findasifrahman/zynq_soc_board_v1/zynq_soc_board_v1.kicad_pcb

## KiCad design zynq_soc_board_v1.kicad_pcb (2024-12-31)

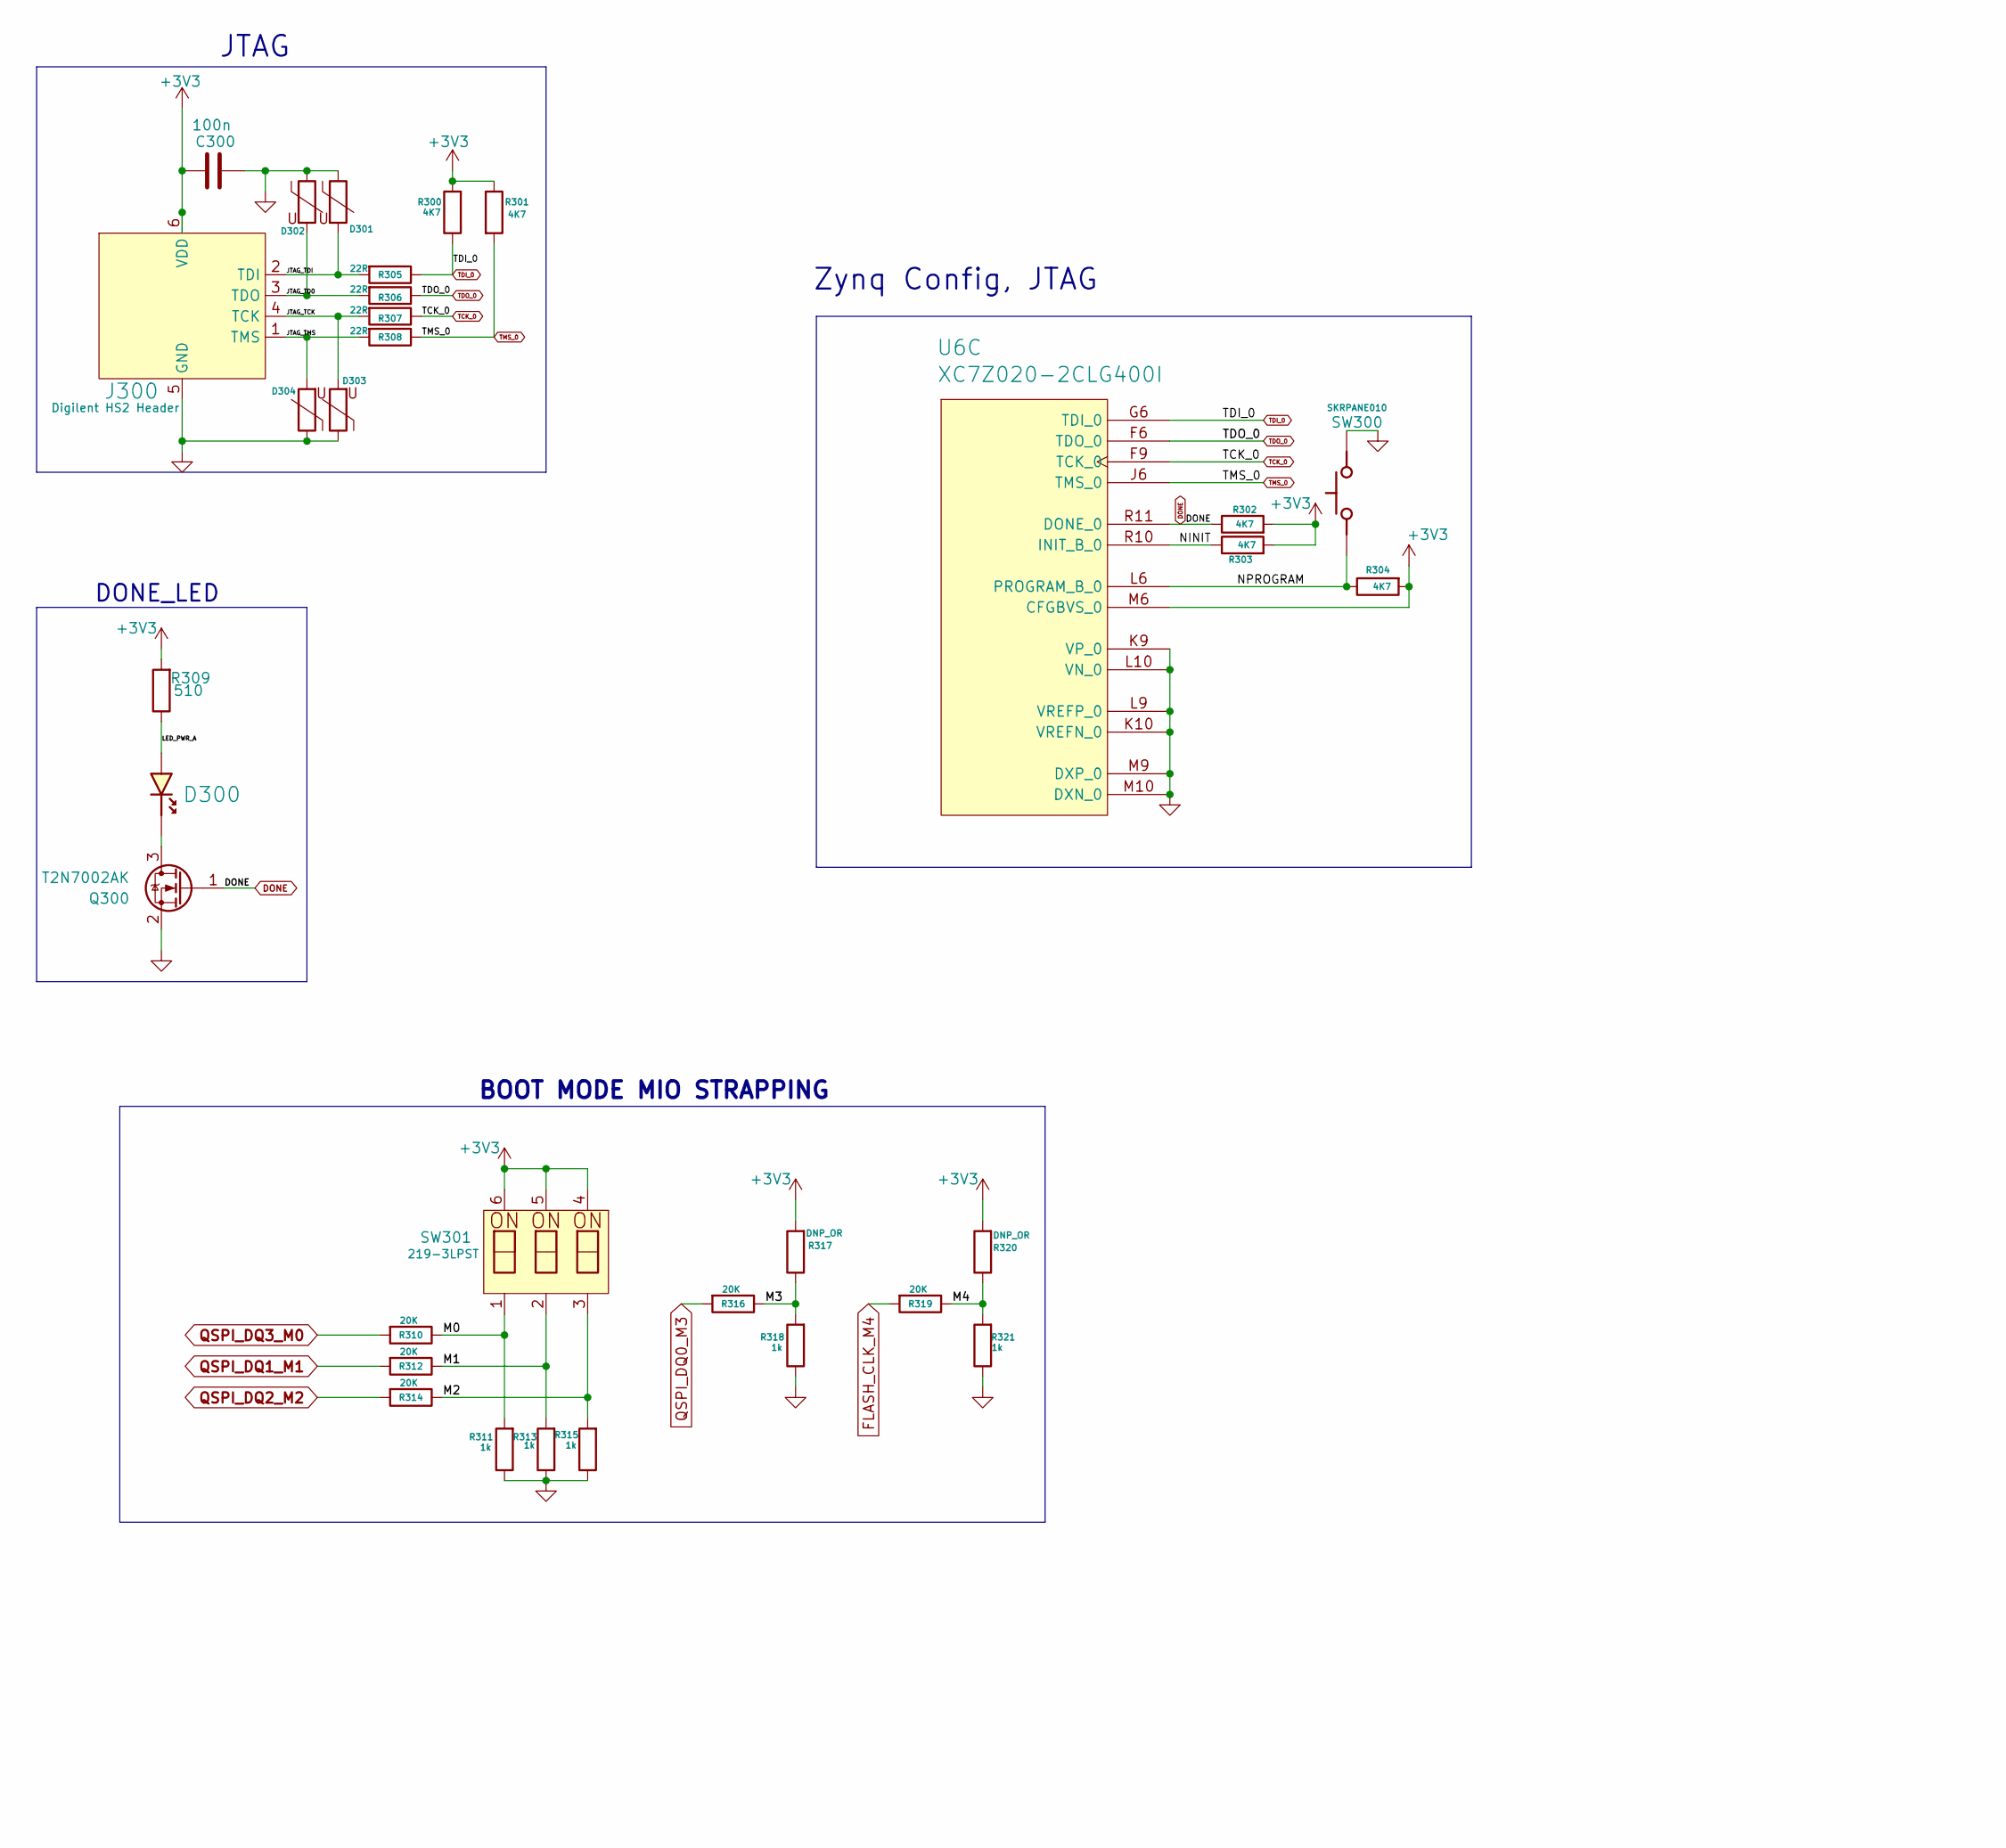
[picture p1: schematic zynq_jtag.kicad_sch, Zynq Config, JTAG, Debug, part in row 1, column 1]

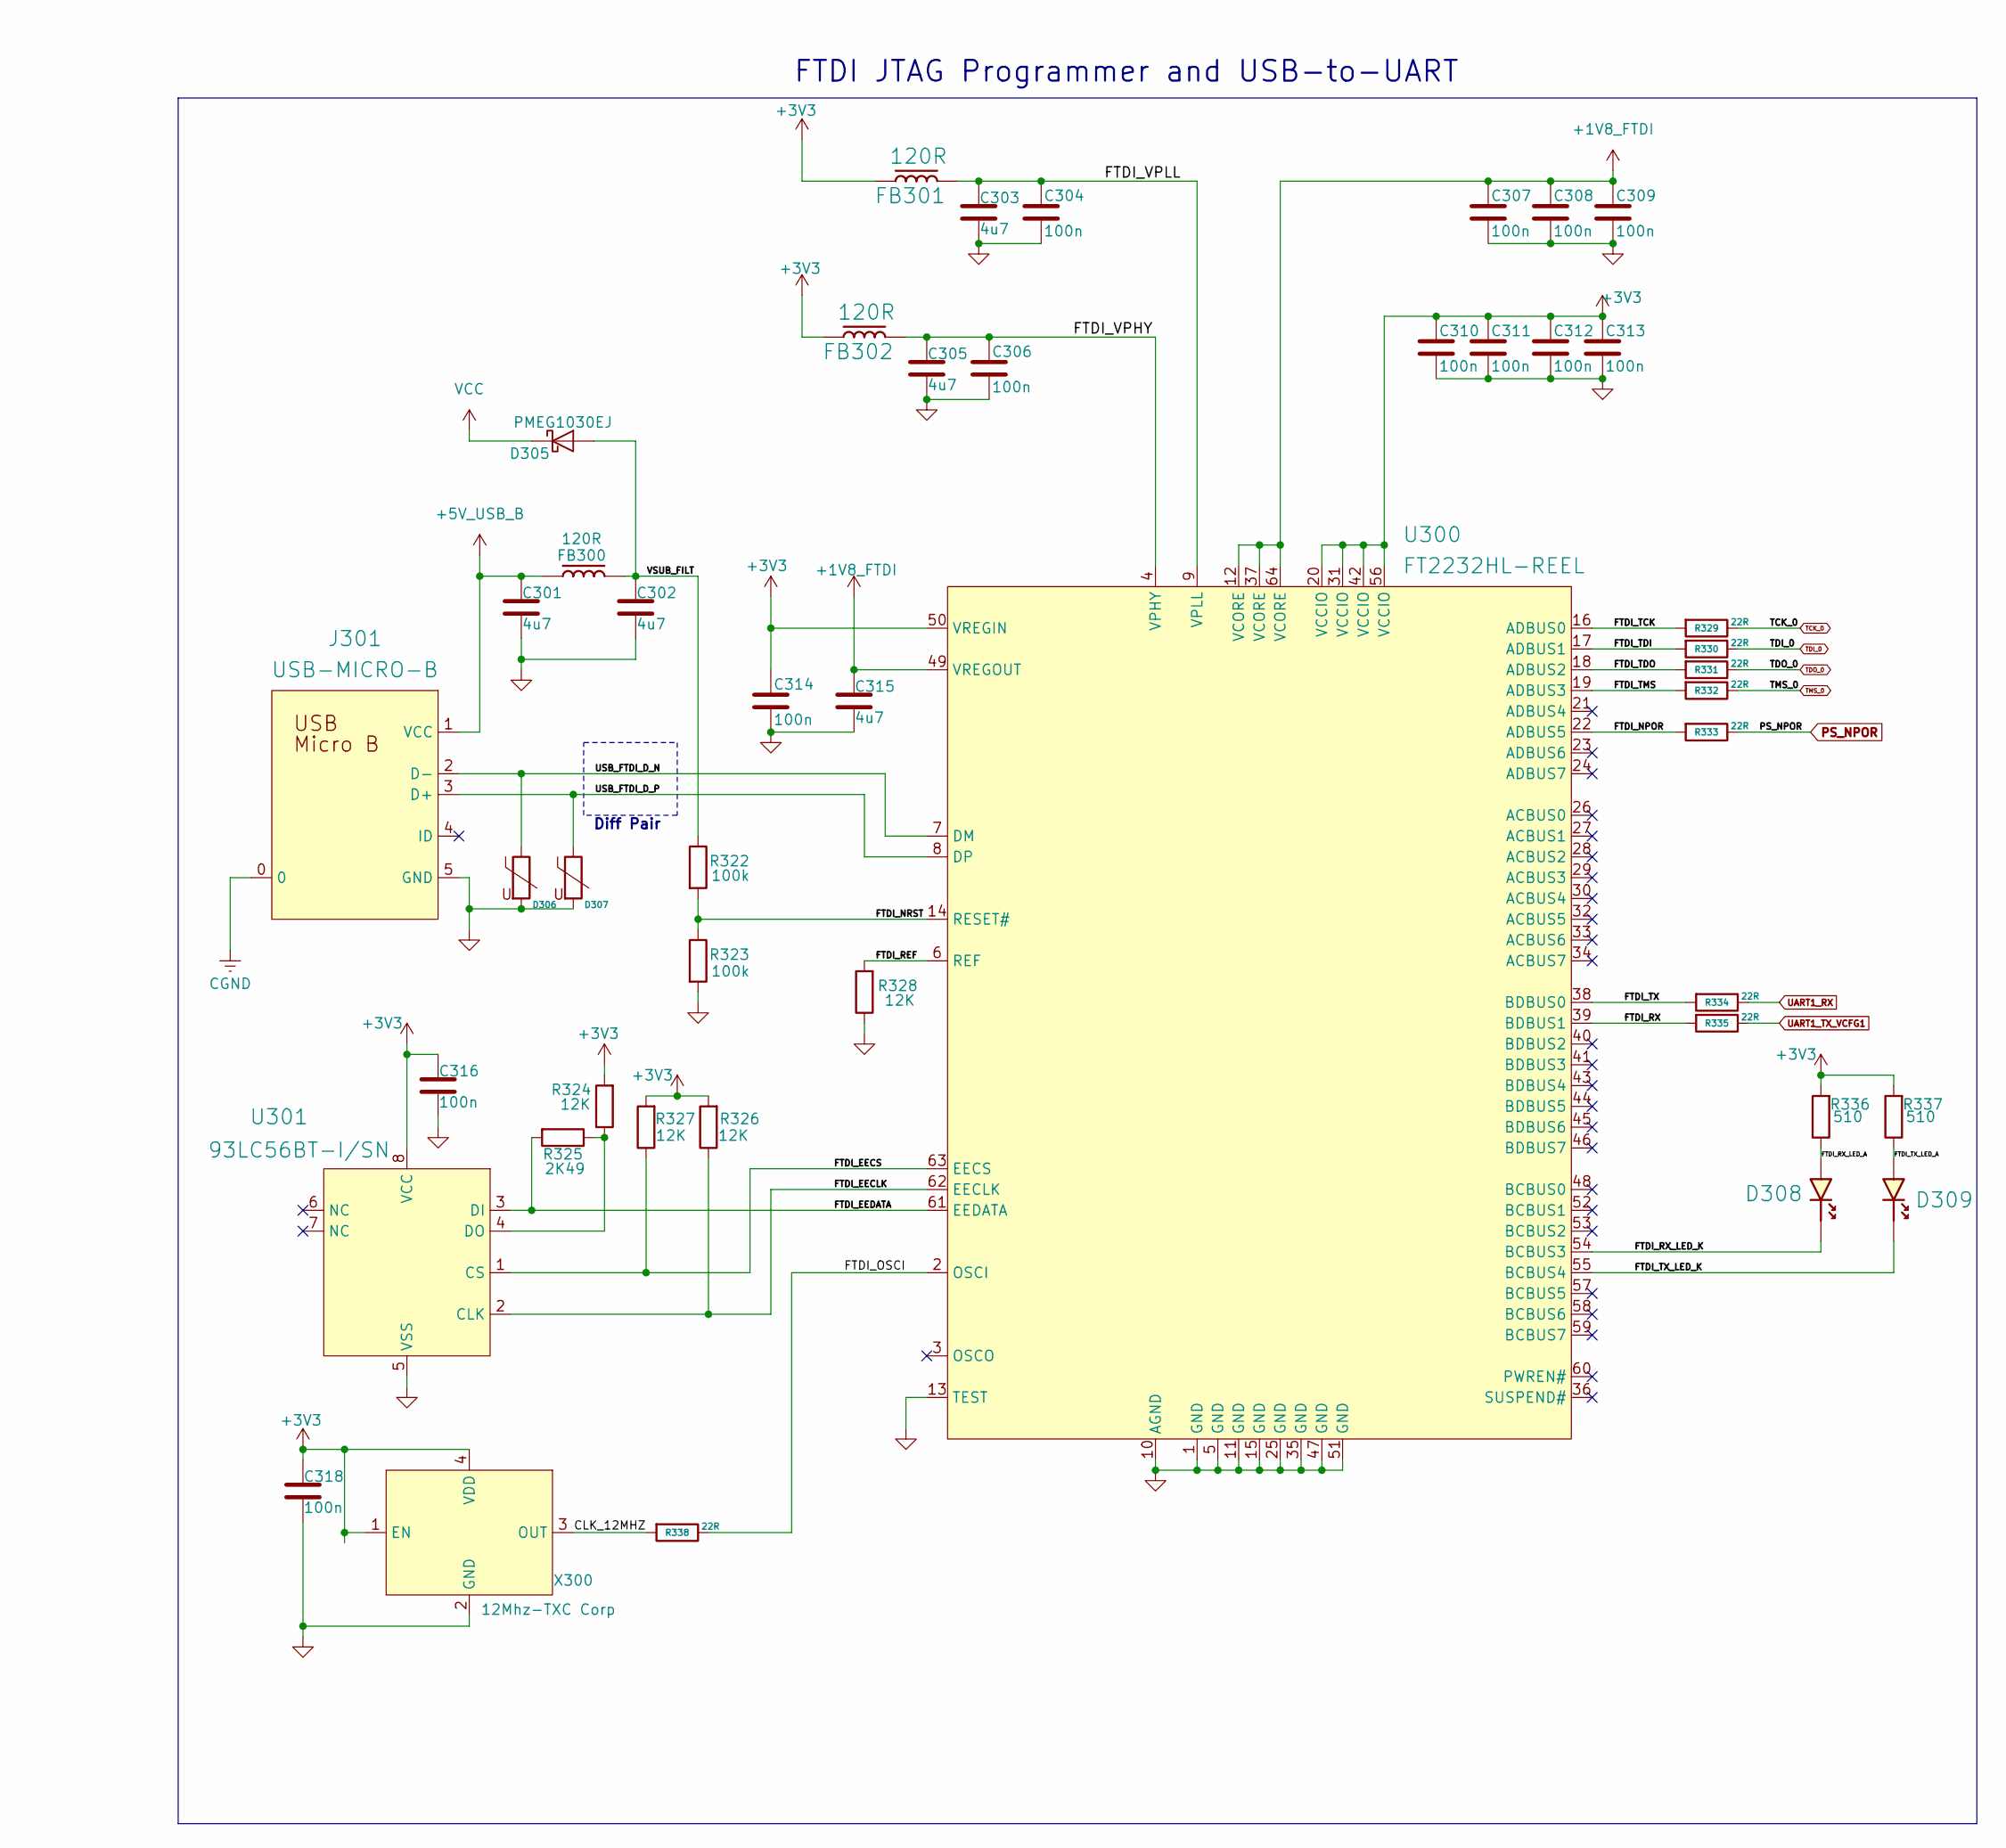
[picture p2: schematic zynq_jtag.kicad_sch, Zynq Config, JTAG, Debug, part in row 1, column 2]

Parts:
C300, C304, C306, C307, C308, C309, C310, C311, C312, C313, C314, C316, C318: 100n; C_0402_1005Metric; Manufacturer Part Number CL05B104KO5NNNC; LCSC C1525
C301, C302, C303, C305, C315: 4u7; C_0402_1005Metric; Manufacturer Part Number CL05A475MP5NRNC; LCSC C23733
D300, D308, D309: RED; LED_0402_RED; Manufacturer Part Number NCD0402R1; LCSC C130719
D301, D302: Varistor; C0402; Manufacturer Part Number CG0402MLU-3.3G; LCSC C2655393
D303, D304, D306, D307: Varistor; D_0402_1005Metric; Manufacturer Part Number CG0402MLU-3.3G; LCSC C2655393
D305: PMEG1030EJ; SOD-323_L1.8-W1.3-LS2.5-RD; LCSC C133633
FB300, FB301, FB302: 120R; FB_0402; Manufacturer Part Number GZ1005D121TF; LCSC C38480
J300: Digilent HS2 Header; DIGILENT_HS2; Manufacturer Part Number 68000-406HLF; LCSC C178289
J301: USB-MICRO-B; MICRO-USB-SMD_5P-P0.65-H-M_MICRO-USB-5P; Manufacturer Part Number 920-D62A2021S10100; LCSC C40942
Q300: T2N7002AK; SOT-23; Manufacturer Part Number T2N7002AK,LM; LCSC C516175
R300, R301, R302, R303, R304: 4K7; R_0402_1005Metric; Manufacturer Part Number 0402WGF4701TCE; LCSC C25900
R305, R306, R307, R308, R329, R330, R331, R332, R333, R334, R335, R338: 22R; R_0402_1005Metric; Manufacturer Part Number 0402WGF220JTCE; LCSC C25092
R309, R336, R337: 510; R_0402_1005Metric; Manufacturer Part Number RC-02W511JT; LCSC C1119
R310, R312, R314, R316, R319: 20K; R0201; Manufacturer Part Number RC0201FR-0720KL; LCSC C295787
R311, R313, R315, R318, R321: 1k; R_0402_1005Metric; Manufacturer Part Number 0402WGF1001TCE; LCSC C11702
R317, R320: DNP_OR; R_0402_1005Metric
R322, R323: 100k; R_0402_1005Metric; Manufacturer Part Number 0402WGF1003TCE; LCSC C25741
R324, R326, R327, R328: 12K; R_0402_1005Metric; Manufacturer Part Number 0402WGF1202TCE; LCSC C25752
R325: 2K49; R_0402_1005Metric; Manufacturer Part Number 0402WGF2491TCE; LCSC C25884
SW300: SKRPANE010; Manufacturer Part Number SKRPANE010; LCSC C470426
SW301: 219-3LPST; Manufacturer Part Number 219-3LPSTR; LCSC C2961925
U6: XC7Z020-2CLG400I; Xilinx_CLG400; PartNumber XC7Z010-1CLG400C; LCSC C569043
U300: FT2232HL-REEL; LQFP-64-0.5mm; Manufacturer Part Number FT2232HL-REEL; LCSC C27882
U301: 93LC56BT-I/SN; SOIC-8; Manufacturer Part Number 93LC56B-I/SN; LCSC C183620
X300: 12Mhz-TXC Corp; XTAL_2520; Manufacturer Part Number 8W12000010; LCSC C409301

Connections:
+1V8_FTDI: C307.1, C308.1, C309.1, C315.1, U300.12 (VCORE), U300.37 (VCORE), U300.49 (VREGOUT), U300.64 (VCORE)
+3V3: C300.1, C310.1, C311.1, C312.1, C313.1, C314.1, C316.1, C318.1, FB301.1, FB302.1, J300.6 (VDD), R300.2, R301.1, R302.2, R303.2, R304.2, R309.2, R317.2, R320.2, R324.2, R326.2, R327.2, R336.2, R337.2, SW301.4, SW301.5, SW301.6, U6.M6 (CFGBVS_0), U300.20 (VCCIO), U300.31 (VCCIO), U300.42 (VCCIO), U300.50 (VREGIN), U300.56 (VCCIO), U301.8 (VCC), X300.1 (EN), X300.4 (VDD); also elsewhere on the board
+5V_USB_B: C301.1, FB300.1, J301.1 (VCC)
/zynq_jtag/CLK_12MHZ: R338.2, X300.3 (OUT)
/zynq_jtag/FTDI_EECLK: R326.1, U300.62 (EECLK), U301.2 (CLK)
/zynq_jtag/FTDI_EECS: R327.1, U300.63 (EECS), U301.1 (CS)
/zynq_jtag/FTDI_EEDATA: R325.2, U300.61 (EEDATA), U301.3 (DI)
/zynq_jtag/FTDI_NPOR: R333.2, U300.22 (ADBUS5)
/zynq_jtag/FTDI_NRST: R322.2, R323.1, U300.14 (RESET#)
/zynq_jtag/FTDI_OSCI: R338.1, U300.2 (OSCI)
/zynq_jtag/FTDI_REF: R328.2, U300.6 (REF)
/zynq_jtag/FTDI_RX: R335.2, U300.39 (BDBUS1)
/zynq_jtag/FTDI_RX_LED_A: D308.A, R336.1
/zynq_jtag/FTDI_RX_LED_K: D308.K, U300.54 (BCBUS3)
/zynq_jtag/FTDI_TCK: R329.2, U300.16 (ADBUS0)
/zynq_jtag/FTDI_TDI: R330.2, U300.17 (ADBUS1)
/zynq_jtag/FTDI_TDO: R331.2, U300.18 (ADBUS2)
/zynq_jtag/FTDI_TMS: R332.2, U300.19 (ADBUS3)
/zynq_jtag/FTDI_TX: R334.2, U300.38 (BDBUS0)
/zynq_jtag/FTDI_TX_LED_A: D309.A, R337.1
/zynq_jtag/FTDI_TX_LED_K: D309.K, U300.55 (BCBUS4)
/zynq_jtag/FTDI_VPHY: C305.1, C306.1, FB302.2, U300.4 (VPHY)
/zynq_jtag/FTDI_VPLL: C303.1, C304.1, FB301.2, U300.9 (VPLL)
/zynq_jtag/JTAG_TCK: D303.2, J300.4 (TCK), R307.2
/zynq_jtag/JTAG_TD0: D302.2, J300.3 (TDO), R306.2
/zynq_jtag/JTAG_TDI: D301.2, J300.2 (TDI), R305.2
/zynq_jtag/JTAG_TMS: D304.2, J300.1 (TMS), R308.2
/zynq_jtag/LED_PWR_A: D300.A, R309.1
/zynq_jtag/M0: R310.1, R311.2, SW301.1
/zynq_jtag/M1: R312.1, R313.2, SW301.2
/zynq_jtag/M2: R314.1, R315.2, SW301.3
/zynq_jtag/M3: R316.1, R317.1, R318.2
/zynq_jtag/M4: R319.1, R320.1, R321.2
/zynq_jtag/NINIT: R303.1, U6.R10 (INIT_B_0)
/zynq_jtag/NPROGRAM: R304.1, SW300.34, U6.L6 (PROGRAM_B_0)
/zynq_jtag/USB_FTDI_D_N: D306.1, J301.2 (D-), U300.7 (DM)
/zynq_jtag/USB_FTDI_D_P: D307.1, J301.3 (D+), U300.8 (DP)
/zynq_jtag/VSUB_FILT: C302.1, D305.2 (A), FB300.2, R322.1
CGND: J301.0; also elsewhere on the board
DONE: Q300.1 (G), R302.1, U6.R11 (DONE_0); also elsewhere on the board
FLASH_CLK_M4: R319.2
GND: C300.2, C301.2, C302.2, C303.2, C304.2, C305.2, C306.2, C307.2, C308.2, C309.2, C310.2, C311.2, C312.2, C313.2, C314.2, C315.2, C316.2, C318.2, D301.1, D302.1, D303.1, D304.1, D306.2, D307.2, J300.5 (GND), J301.5 (GND), Q300.2 (S), R311.1, R313.1, R315.1, R318.1, R321.1, R323.2, R328.1, SW300.12, U6.K9 (VP_0), U6.K10 (VREFN_0), U6.L9 (VREFP_0), U6.L10 (VN_0), U6.M9 (DXP_0), U6.M10 (DXN_0), U300.1 (GND), U300.5 (GND), U300.10 (AGND), U300.11 (GND), U300.13 (TEST), U300.15 (GND), U300.25 (GND), U300.35 (GND), U300.47 (GND), U300.51 (GND), U301.5 (VSS), X300.2 (GND); also elsewhere on the board
unnamed: D300.K, Q300.3 (D)
unnamed: R324.1, R325.1, U301.4 (DO)
PS_NPOR: R333.1; also elsewhere on the board
QSPI_DQ0_M3: R316.2; also elsewhere on the board
QSPI_DQ1_M1: R312.2; also elsewhere on the board
QSPI_DQ2_M2: R314.2; also elsewhere on the board
QSPI_DQ3_M0: R310.2; also elsewhere on the board
TCK_0: R307.1, R329.1, U6.F9 (TCK_0)
TDI_0: R300.1, R305.1, R330.1, U6.G6 (TDI_0)
TDO_0: R306.1, R331.1, U6.F6 (TDO_0)
TMS_0: R301.2, R308.1, R332.1, U6.J6 (TMS_0)
UART1_RX: R334.1; also elsewhere on the board
UART1_TX_VCFG1: R335.1; also elsewhere on the board
VCC: D305.1 (K); also elsewhere on the board

Notes on the sheet:
Diff Pair
JTAG
Zynq Config, JTAG
BOOT MODE MIO STRAPPING
FTDI JTAG Programmer and USB-to-UART
DONE_LED
