findasifrahman/zynq_soc_board_v1/zynq_soc_board_v1.kicad_pcb

## KiCad design zynq_soc_board_v1.kicad_pcb (continued)

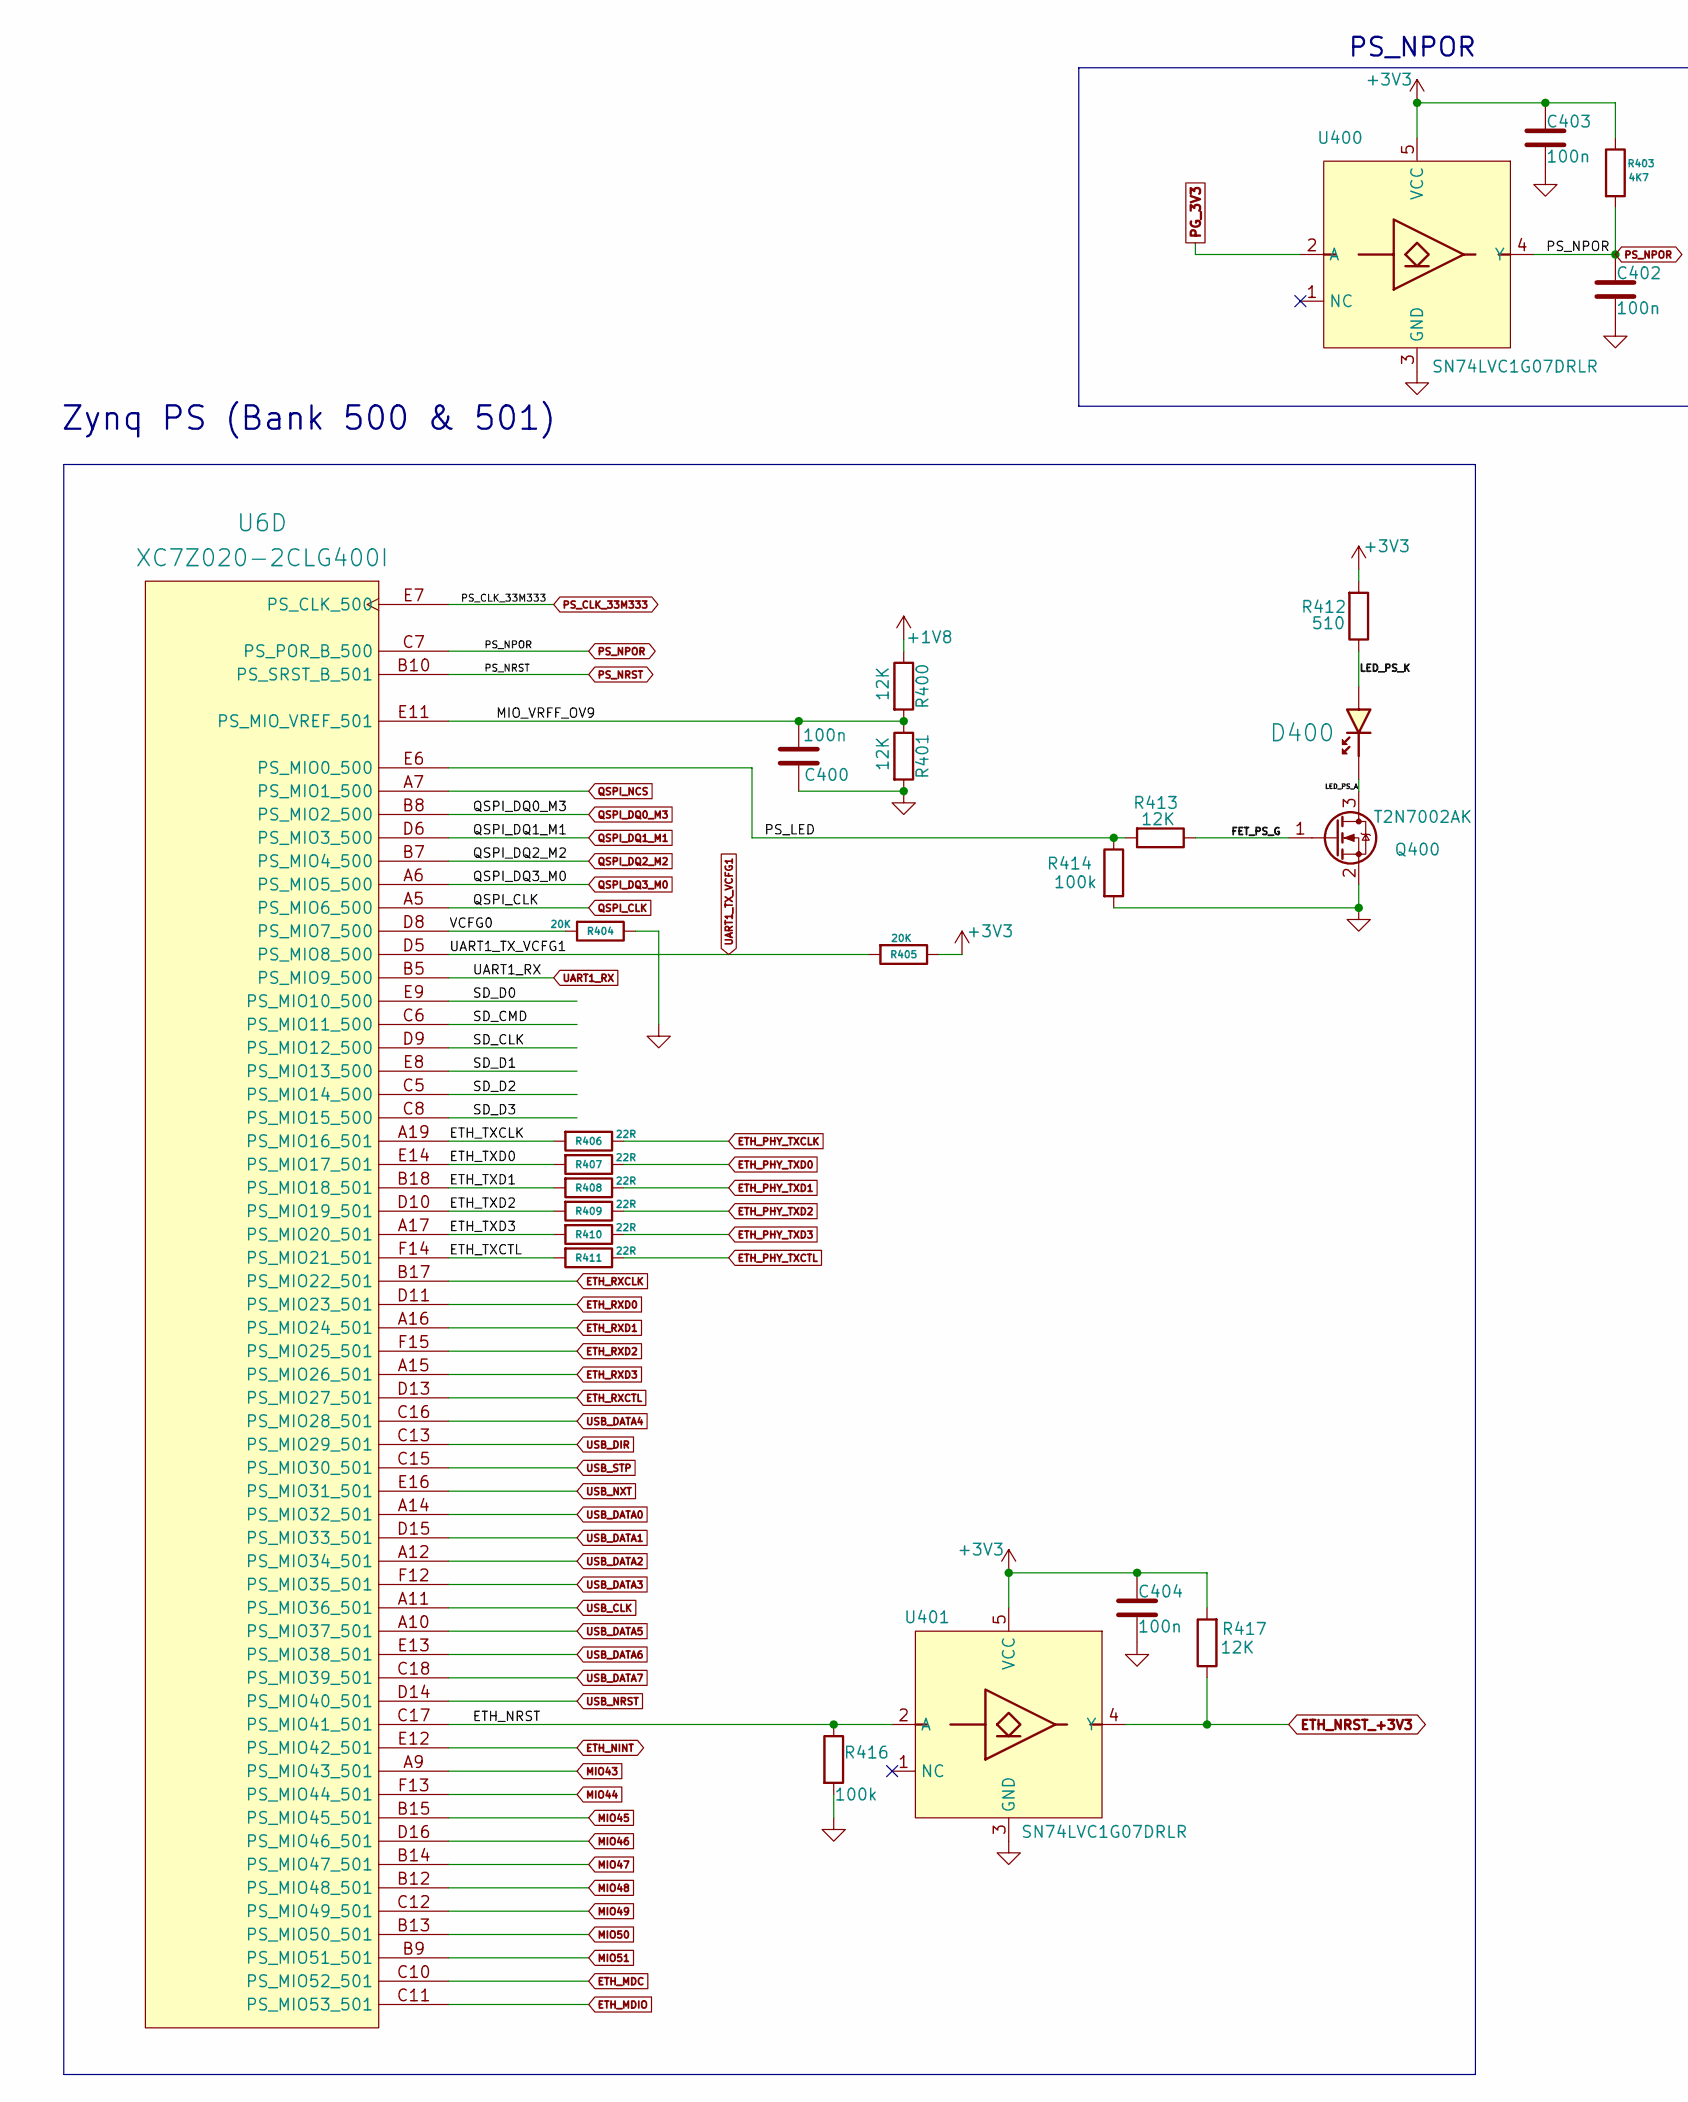
[picture p3: schematic zynq_processing_system_ps.kicad_sch, part in row 1, column 1]

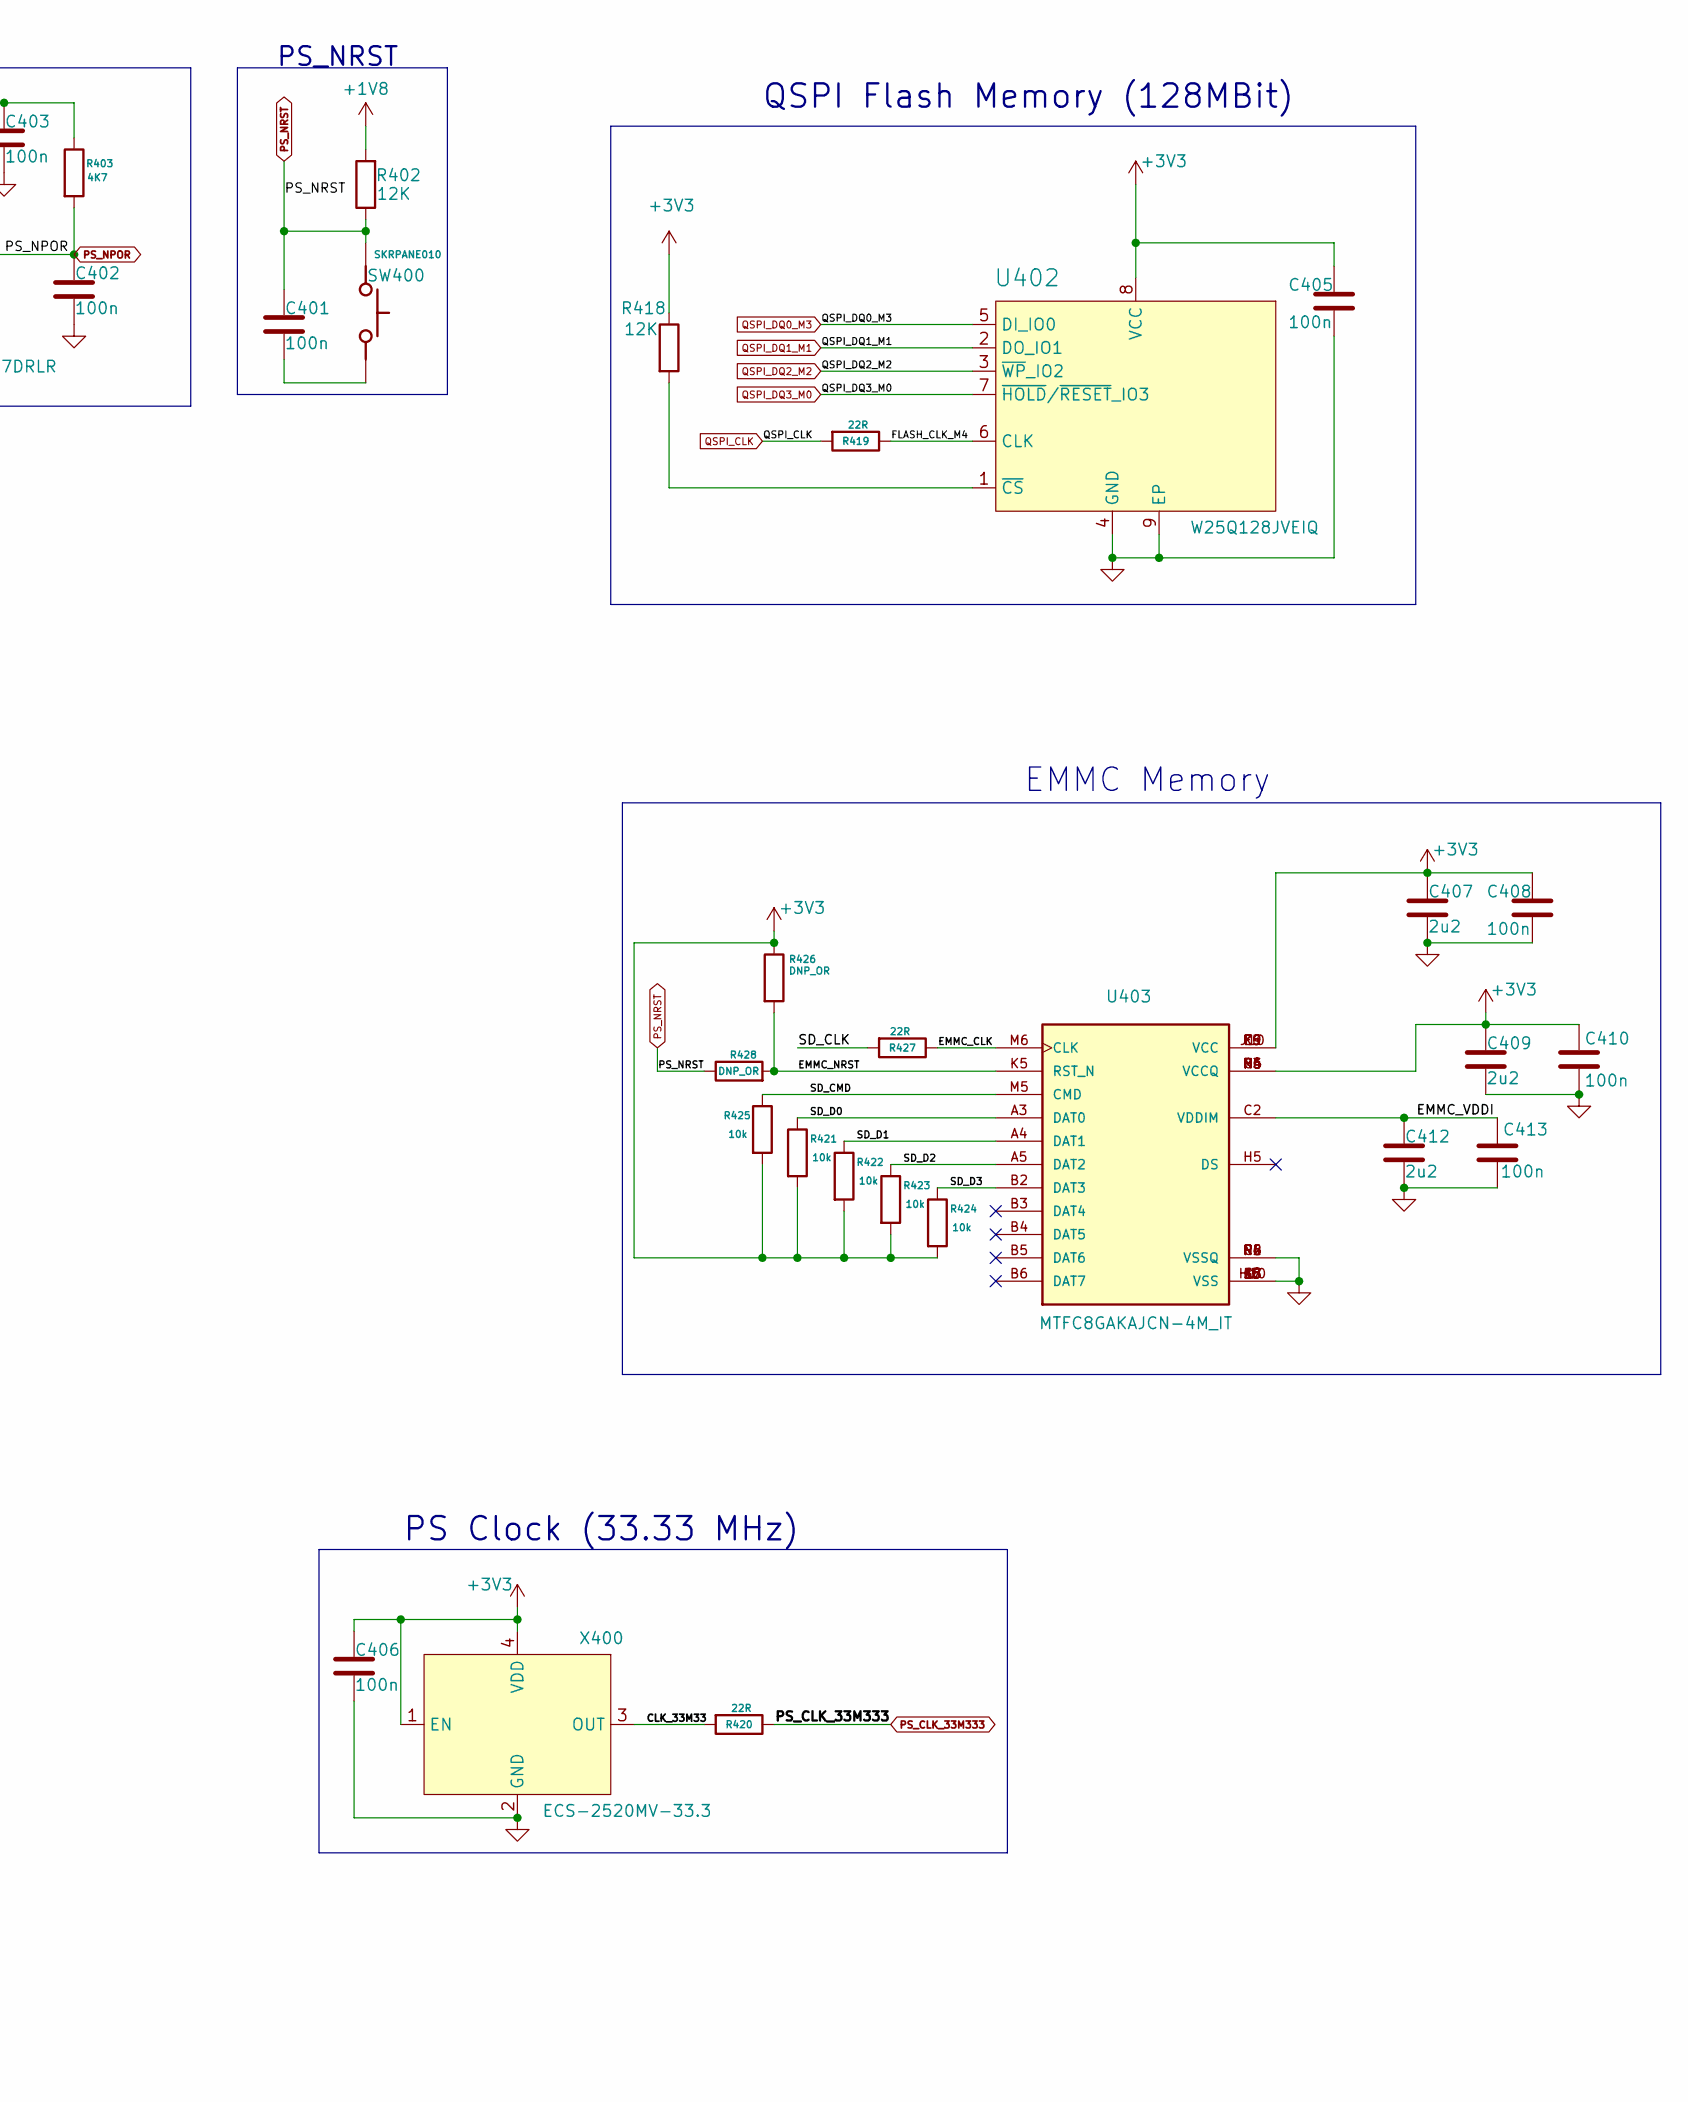
[picture p4: schematic zynq_processing_system_ps.kicad_sch, part in row 1, column 2]

Parts:
C400, C401, C402, C403, C404, C405, C406, C408, C410, C413: 100n; C_0402_1005Metric; Manufacturer Part Number CL05B104KO5NNNC; LCSC C1525
C407, C409, C412: 2u2; C_0402_1005Metric; Manufacturer Part Number CL05A225MQ5NSNC; LCSC C12530
D400: RED; LED_0402_RED; Manufacturer Part Number NCD0402R1; LCSC C130719
Q400: T2N7002AK; SOT-23; Manufacturer Part Number T2N7002AK,LM; LCSC C516175
R400, R401, R402, R413, R417, R418: 12K; R_0402_1005Metric; Manufacturer Part Number 0402WGF1202TCE; LCSC C25752
R403: 4K7; R_0402_1005Metric; Manufacturer Part Number 0402WGF4701TCE; LCSC C25900
R404, R405: 20K; R0201; Manufacturer Part Number RC0201FR-0720KL; LCSC C295787
R406, R407, R408, R409, R410, R411, R419, R420, R427: 22R; R_0402_1005Metric; Manufacturer Part Number 0402WGF220JTCE; LCSC C25092
R412: 510; R_0402_1005Metric; Manufacturer Part Number RC-02W511JT; LCSC C1119
R414, R416: 100k; R_0402_1005Metric; Manufacturer Part Number 0402WGF1003TCE; LCSC C25741
R421, R422, R423, R424, R425: 10k; R_0402_1005Metric; Manufacturer Part Number 0402WGF1002TCE; LCSC C25744
R426, R428: DNP_OR; R_0402_1005Metric
SW400: SKRPANE010; Manufacturer Part Number SKRPANE010; LCSC C470426
U6: XC7Z020-2CLG400I; Xilinx_CLG400; PartNumber XC7Z010-1CLG400C; LCSC C569043
U400, U401: SN74LVC1G07DRLR; SOT-5; Manufacturer Part Number SN74LVC1G07DRLR; LCSC C183013
U402: W25Q128JVEIQ; WSON-8-8X6; Manufacturer Part Number W25Q128JVEIQ; LCSC C401662
U403: MTFC8GAKAJCN-4M_IT; FBGA-153_L13.0-W11.5-P0.50_KLMAG1JETD-B041; LCSC C395384
X400: ECS-2520MV-33.3; XTAL_2520; Manufacturer Part Number ECS-2520MV-333.3-BN-TR; LCSC C405468

Connections:
+1V8: R400.1, R402.2; also elsewhere on the board
+3V3: C403.1, C404.1, C405.1, C406.1, C407.1, C408.1, C409.1, C410.1, R403.1, R405.1, R412.2, R417.2, R418.1, R421.2, R422.2, R423.2, R424.2, R425.2, R426.1, U400.5 (VCC), U401.5 (VCC), U402.8 (VCC), U403.C6 (VCCQ), U403.E6 (VCC), U403.F5 (VCC), U403.J10 (VCC), U403.K9 (VCC), U403.M4 (VCCQ), U403.N4 (VCCQ), U403.P3 (VCCQ), U403.P5 (VCCQ), X400.1 (EN), X400.4 (VDD); also elsewhere on the board
/zynq_processing_system_ps/CLK_33M33: R420.2, X400.3 (OUT)
/zynq_processing_system_ps/EMMC_CLK: R427.1, U403.M6 (CLK)
/zynq_processing_system_ps/EMMC_NRST: R426.2, R428.2, U403.K5 (RST_N)
/zynq_processing_system_ps/EMMC_VDDI: C412.1, C413.1, U403.C2 (VDDIM)
/zynq_processing_system_ps/ETH_NRST: R416.1, U6.C17 (PS_MIO41_501), U401.2 (A)
/zynq_processing_system_ps/ETH_TXCLK: R406.2, U6.A19 (PS_MIO16_501)
/zynq_processing_system_ps/ETH_TXCTL: R411.2, U6.F14 (PS_MIO21_501)
/zynq_processing_system_ps/ETH_TXD0: R407.2, U6.E14 (PS_MIO17_501)
/zynq_processing_system_ps/ETH_TXD1: R408.2, U6.B18 (PS_MIO18_501)
/zynq_processing_system_ps/ETH_TXD2: R409.2, U6.D10 (PS_MIO19_501)
/zynq_processing_system_ps/ETH_TXD3: R410.2, U6.A17 (PS_MIO20_501)
/zynq_processing_system_ps/FET_PS_G: Q400.1 (G), R413.1
/zynq_processing_system_ps/FLASH_CLK_M4: R419.1, U402.6 (CLK)
/zynq_processing_system_ps/LED_PS_A: D400.K, Q400.3 (D)
/zynq_processing_system_ps/LED_PS_K: D400.A, R412.1
/zynq_processing_system_ps/MIO_VRFF_OV9: C400.2, R400.2, R401.1, U6.E11 (PS_MIO_VREF_501)
/zynq_processing_system_ps/PS_LED: R413.2, R414.1, U6.E6 (PS_MIO0_500)
/zynq_processing_system_ps/SD_CLK: R427.2, U6.D9 (PS_MIO12_500)
/zynq_processing_system_ps/SD_CMD: R425.1, U6.C6 (PS_MIO11_500), U403.M5 (CMD)
/zynq_processing_system_ps/SD_D0: R421.1, U6.E9 (PS_MIO10_500), U403.A3 (DAT0)
/zynq_processing_system_ps/SD_D1: R422.1, U6.E8 (PS_MIO13_500), U403.A4 (DAT1)
/zynq_processing_system_ps/SD_D2: R423.1, U6.C5 (PS_MIO14_500), U403.A5 (DAT2)
/zynq_processing_system_ps/SD_D3: R424.1, U6.C8 (PS_MIO15_500), U403.B2 (DAT3)
/zynq_processing_system_ps/VCFG0: R404.2, U6.D8 (PS_MIO7_500)
ETH_MDC: U6.C10 (PS_MIO52_501); also elsewhere on the board
ETH_MDIO: U6.C11 (PS_MIO53_501); also elsewhere on the board
ETH_NINT: U6.E12 (PS_MIO42_501); also elsewhere on the board
ETH_NRST_+3V3: R417.1, U401.4 (Y); also elsewhere on the board
ETH_PHY_TXCLK: R406.1; also elsewhere on the board
ETH_PHY_TXCTL: R411.1; also elsewhere on the board
ETH_PHY_TXD0: R407.1; also elsewhere on the board
ETH_PHY_TXD1: R408.1; also elsewhere on the board
ETH_PHY_TXD2: R409.1; also elsewhere on the board
ETH_PHY_TXD3: R410.1; also elsewhere on the board
ETH_RXCLK: U6.B17 (PS_MIO22_501); also elsewhere on the board
ETH_RXCTL: U6.D13 (PS_MIO27_501); also elsewhere on the board
ETH_RXD0: U6.D11 (PS_MIO23_501); also elsewhere on the board
ETH_RXD1: U6.A16 (PS_MIO24_501); also elsewhere on the board
ETH_RXD2: U6.F15 (PS_MIO25_501); also elsewhere on the board
ETH_RXD3: U6.A15 (PS_MIO26_501); also elsewhere on the board
GND: C400.1, C402.2, C403.2, C404.2, C405.2, C406.2, C407.2, C408.2, C409.2, C410.2, C412.2, C413.2, Q400.2 (S), R401.2, R404.1, R414.2, R416.2, U400.3 (GND), U401.3 (GND), U402.4 (GND), U402.9 (EP), U403.A6 (VSS), U403.C4 (VSSQ), U403.E7 (VSS), U403.G5 (VSS), U403.H10 (VSS), U403.J5 (VSS), U403.K8 (VSS), U403.N2 (VSSQ), U403.N5 (VSSQ), U403.P4 (VSSQ), U403.P6 (VSSQ), X400.2 (GND); also elsewhere on the board
MIO43: U6.A9 (PS_MIO43_501)
MIO44: U6.F13 (PS_MIO44_501)
MIO45: U6.B15 (PS_MIO45_501)
MIO46: U6.D16 (PS_MIO46_501)
MIO47: U6.B14 (PS_MIO47_501)
MIO48: U6.B12 (PS_MIO48_501)
MIO49: U6.C12 (PS_MIO49_501); also elsewhere on the board
MIO50: U6.B13 (PS_MIO50_501); also elsewhere on the board
MIO51: U6.B9 (PS_MIO51_501); also elsewhere on the board
unnamed: C401.2, SW400.34
unnamed: R418.2, U402.1 (~CS)
PG_3V3: U400.2 (A); also elsewhere on the board
PS_CLK_33M333: R420.1, U6.E7 (PS_CLK_500)
PS_NPOR: C402.1, R403.2, U6.C7 (PS_POR_B_500), U400.4 (Y); also elsewhere on the board
PS_NRST: C401.1, R402.1, R428.1, SW400.12, U6.B10 (PS_SRST_B_501)
QSPI_CLK: R419.2, U6.A5 (PS_MIO6_500)
QSPI_DQ0_M3: U6.B8 (PS_MIO2_500), U402.5 (DI_IO0); also elsewhere on the board
QSPI_DQ1_M1: U6.D6 (PS_MIO3_500), U402.2 (DO_IO1); also elsewhere on the board
QSPI_DQ2_M2: U6.B7 (PS_MIO4_500), U402.3 (~WP_IO2); also elsewhere on the board
QSPI_DQ3_M0: U6.A6 (PS_MIO5_500), U402.7 (~HOLD/~RESET_IO3); also elsewhere on the board
QSPI_NCS: U6.A7 (PS_MIO1_500)
UART1_RX: U6.B5 (PS_MIO9_500); also elsewhere on the board
UART1_TX_VCFG1: R405.2, U6.D5 (PS_MIO8_500); also elsewhere on the board
USB_CLK: U6.A11 (PS_MIO36_501); also elsewhere on the board
USB_DATA0: U6.A14 (PS_MIO32_501); also elsewhere on the board
USB_DATA1: U6.D15 (PS_MIO33_501); also elsewhere on the board
USB_DATA2: U6.A12 (PS_MIO34_501); also elsewhere on the board
USB_DATA3: U6.F12 (PS_MIO35_501); also elsewhere on the board
USB_DATA4: U6.C16 (PS_MIO28_501); also elsewhere on the board
USB_DATA5: U6.A10 (PS_MIO37_501); also elsewhere on the board
USB_DATA6: U6.E13 (PS_MIO38_501); also elsewhere on the board
USB_DATA7: U6.C18 (PS_MIO39_501); also elsewhere on the board
USB_DIR: U6.C13 (PS_MIO29_501); also elsewhere on the board
USB_NRST: U6.D14 (PS_MIO40_501); also elsewhere on the board
USB_NXT: U6.E16 (PS_MIO31_501); also elsewhere on the board
USB_STP: U6.C15 (PS_MIO30_501); also elsewhere on the board

Notes on the sheet:
PS_NPOR
QSPI Flash Memory (128MBit)
EMMC Memory
Zynq PS (Bank 500 & 501)
PS_NRST
PS Clock (33.33 MHz)

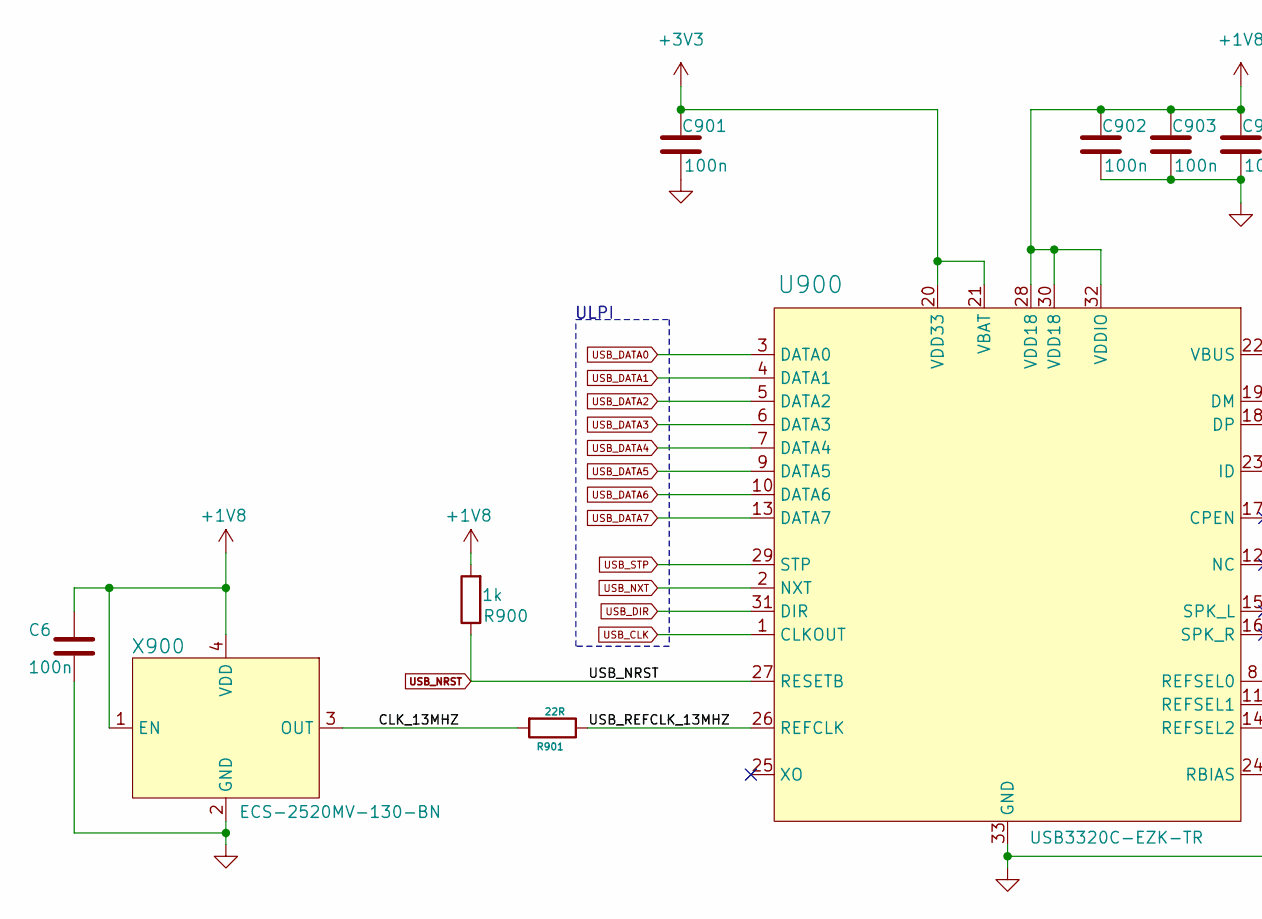
[picture p5: schematic USB-2-HS.kicad_sch, USB 2.0 High-Speed (OTG), part in row 1, column 1]

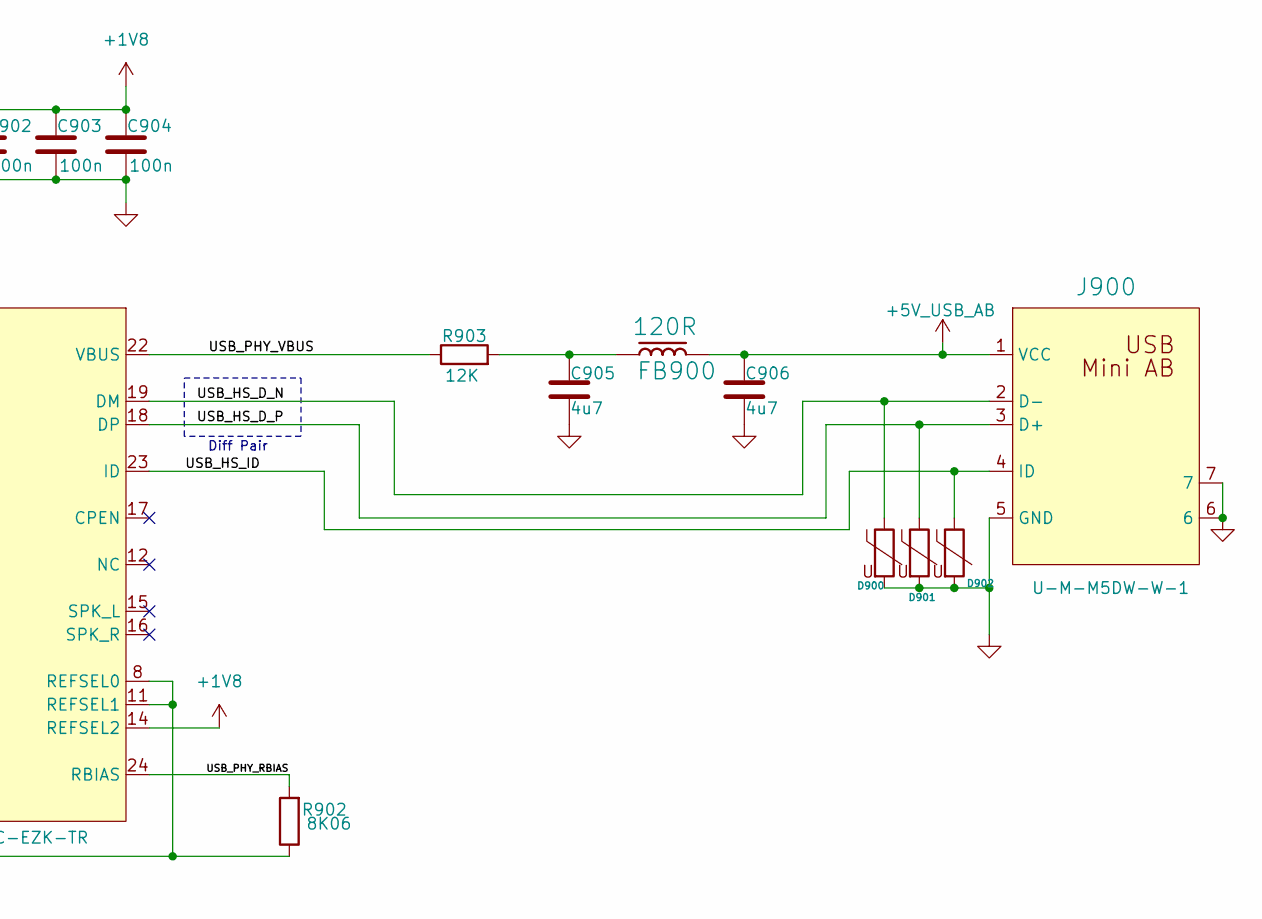
[picture p6: schematic USB-2-HS.kicad_sch, USB 2.0 High-Speed (OTG), part in row 1, column 2]

Parts:
C6, C901, C902, C903, C904: 100n; C_0402_1005Metric; Manufacturer Part Number CL05B104KO5NNNC; LCSC C1525
C905, C906: 4u7; C_0402_1005Metric; Manufacturer Part Number CL05A475MP5NRNC; LCSC C23733
D900, D901, D902: Varistor; C0402; Manufacturer Part Number CG0402MLU-3.3G; LCSC C2655393
FB900: 120R; FB_0402; Manufacturer Part Number GZ1005D121TF; LCSC C38480
J900: U-M-M5DW-W-1; MINI-USB-TH_U-M-M5DW-W-1; Manufacturer Part Number U-M-M5DW-W-1; LCSC C530648
R900: 1k; R_0402_1005Metric; Manufacturer Part Number 0402WGF1001TCE; LCSC C11702
R901: 22R; R_0402_1005Metric; Manufacturer Part Number 0402WGF220JTCE; LCSC C25092
R902: 8K06; R_0402_1005Metric; Manufacturer Part Number 0402WGF8061TCE; LCSC C25923
R903: 12K; R_0402_1005Metric; Manufacturer Part Number 0402WGF1202TCE; LCSC C25752
U900: USB3320C-EZK-TR; QFN-32-5x5x0.85mm; Manufacturer Part Number USB3320C-EZK-TR; LCSC C132156
X900: ECS-2520MV-130-BN; XTAL_2520; Manufacturer Part Number ECS-2520MV-130-BN-TR; LCSC C2613032

Connections:
+1V8: C6.1, C902.1, C903.1, C904.1, R900.2, U900.14 (REFSEL2), U900.28 (VDD18), U900.30 (VDD18), U900.32 (VDDIO), X900.1 (EN), X900.4 (VDD); also elsewhere on the board
+3V3: C901.1, U900.20 (VDD33), U900.21 (VBAT); also elsewhere on the board
+5V_USB_AB: C906.1, FB900.2, J900.1 (VCC)
/USB-2-HS/CLK_13MHZ: R901.2, X900.3 (OUT)
/USB-2-HS/USB_HS_D_N: D900.1, J900.2 (D-), U900.19 (DM)
/USB-2-HS/USB_HS_D_P: D901.1, J900.3 (D+), U900.18 (DP)
/USB-2-HS/USB_HS_ID: D902.1, J900.4 (ID), U900.23 (ID)
/USB-2-HS/USB_PHY_RBIAS: R902.2, U900.24 (RBIAS)
/USB-2-HS/USB_PHY_VBUS: R903.1, U900.22 (VBUS)
/USB-2-HS/USB_REFCLK_13MHZ: R901.1, U900.26 (REFCLK)
GND: C6.2, C901.2, C902.2, C903.2, C904.2, C905.2, C906.2, D900.2, D901.2, D902.2, J900.5 (GND), J900.6, J900.7, R902.1, U900.8 (REFSEL0), U900.11 (REFSEL1), U900.33 (GND), X900.2 (GND); also elsewhere on the board
unnamed: C905.1, FB900.1, R903.2
USB_CLK: U900.1 (CLKOUT); also elsewhere on the board
USB_DATA0: U900.3 (DATA0); also elsewhere on the board
USB_DATA1: U900.4 (DATA1); also elsewhere on the board
USB_DATA2: U900.5 (DATA2); also elsewhere on the board
USB_DATA3: U900.6 (DATA3); also elsewhere on the board
USB_DATA4: U900.7 (DATA4); also elsewhere on the board
USB_DATA5: U900.9 (DATA5); also elsewhere on the board
USB_DATA6: U900.10 (DATA6); also elsewhere on the board
USB_DATA7: U900.13 (DATA7); also elsewhere on the board
USB_DIR: U900.31 (DIR); also elsewhere on the board
USB_NRST: R900.1, U900.27 (RESETB); also elsewhere on the board
USB_NXT: U900.2 (NXT); also elsewhere on the board
USB_STP: U900.29 (STP); also elsewhere on the board

Notes on the sheet:
ULPI
Diff Pair

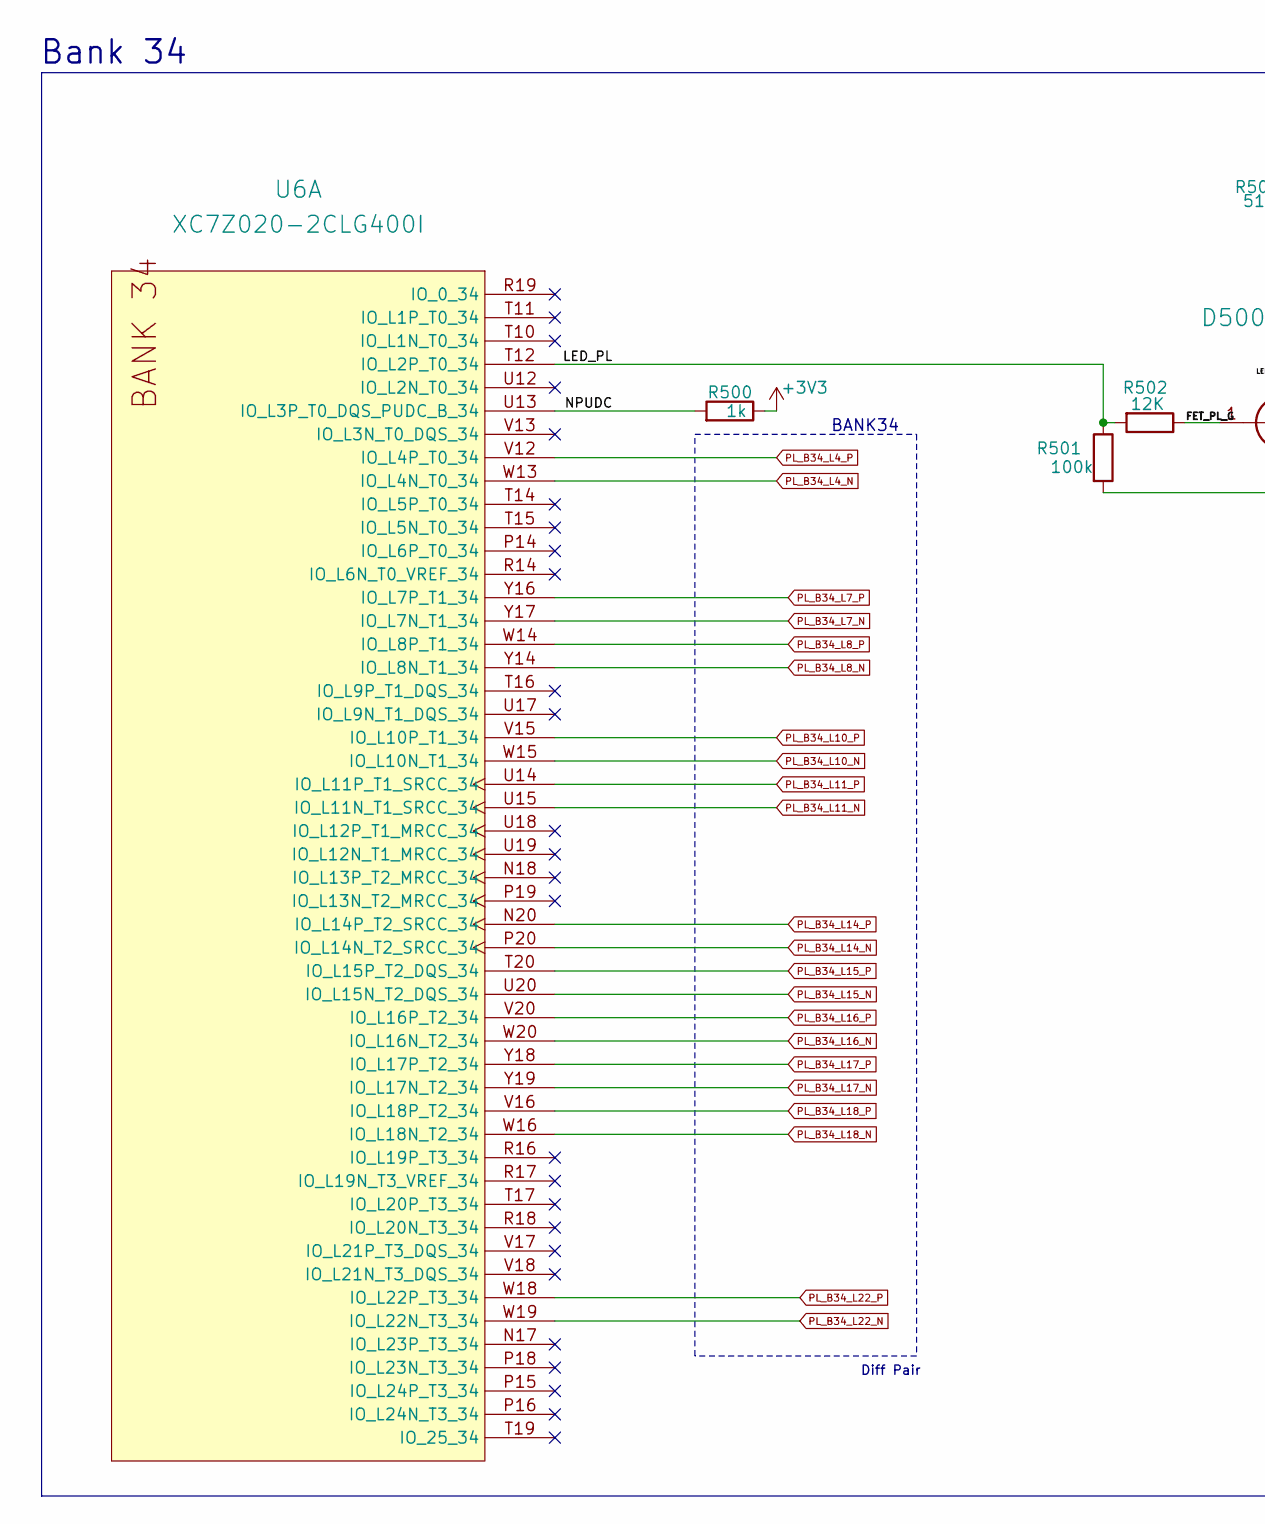
[picture p7: schematic zynq_programmable_logic.kicad_sch, Zynq Programmable Logic (PL), part in row 1, column 1]

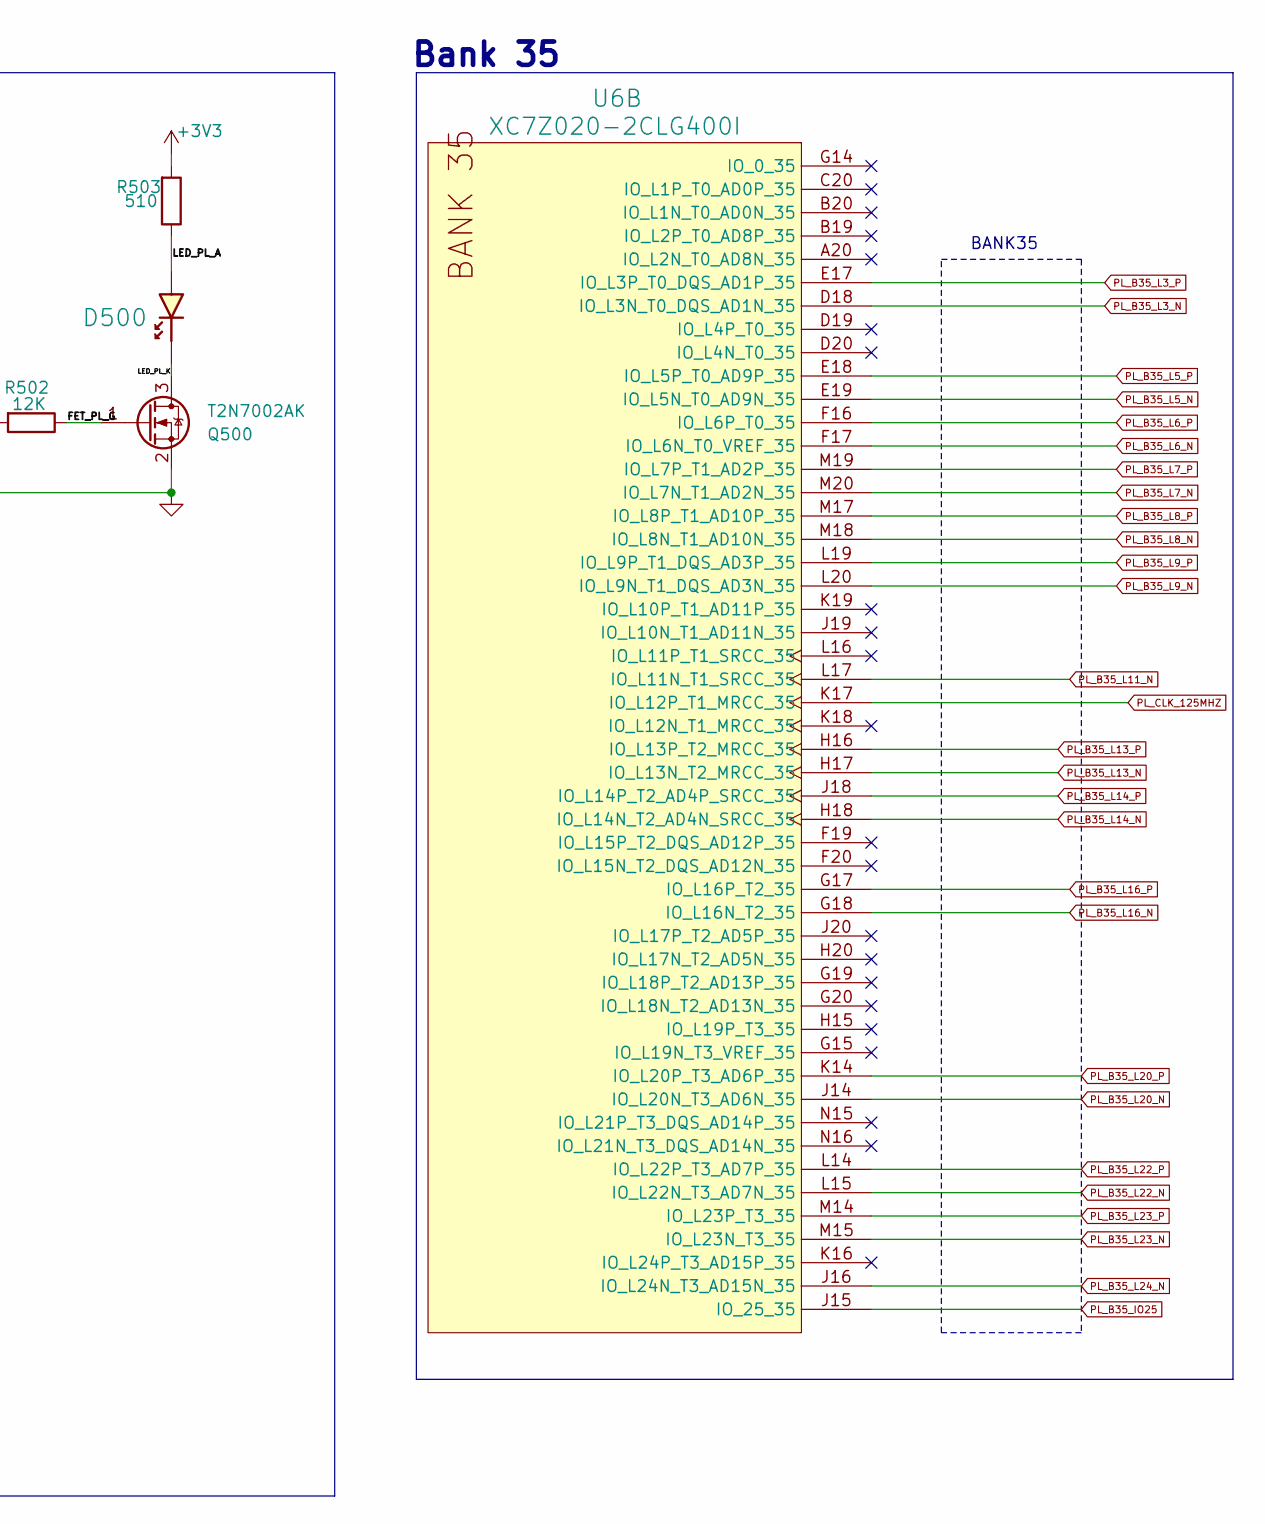
[picture p8: schematic zynq_programmable_logic.kicad_sch, Zynq Programmable Logic (PL), part in row 1, column 2]

Parts:
D500: RED; LED_0402_RED; Manufacturer Part Number NCD0402R1; LCSC C130719
Q500: T2N7002AK; SOT-23; Manufacturer Part Number T2N7002AK,LM; LCSC C516175
R500: 1k; R_0402_1005Metric; Manufacturer Part Number 0402WGF1001TCE; LCSC C11702
R501: 100k; R_0402_1005Metric; Manufacturer Part Number 0402WGF1003TCE; LCSC C25741
R502: 12K; R_0402_1005Metric; Manufacturer Part Number 0402WGF1202TCE; LCSC C25752
R503: 510; R_0402_1005Metric; Manufacturer Part Number RC-02W511JT; LCSC C1119
U6: XC7Z020-2CLG400I; Xilinx_CLG400; PartNumber XC7Z010-1CLG400C; LCSC C569043

Connections:
+3V3: R500.1, R503.2; also elsewhere on the board
/zynq_programmable_logic/FET_PL_G: Q500.1 (G), R502.1
/zynq_programmable_logic/LED_PL: R501.1, R502.2, U6.T12 (IO_L2P_T0_34)
/zynq_programmable_logic/LED_PL_A: D500.A, R503.1
/zynq_programmable_logic/LED_PL_K: D500.K, Q500.3 (D)
/zynq_programmable_logic/NPUDC: R500.2, U6.U13 (IO_L3P_T0_DQS_PUDC_B_34)
GND: Q500.2 (S), R501.2; also elsewhere on the board
PL_B34_L4_N: U6.W13 (IO_L4N_T0_34); also elsewhere on the board
PL_B34_L4_P: U6.V12 (IO_L4P_T0_34); also elsewhere on the board
PL_B34_L7_N: U6.Y17 (IO_L7N_T1_34); also elsewhere on the board
PL_B34_L7_P: U6.Y16 (IO_L7P_T1_34); also elsewhere on the board
PL_B34_L8_N: U6.Y14 (IO_L8N_T1_34); also elsewhere on the board
PL_B34_L8_P: U6.W14 (IO_L8P_T1_34); also elsewhere on the board
PL_B34_L10_N: U6.W15 (IO_L10N_T1_34); also elsewhere on the board
PL_B34_L10_P: U6.V15 (IO_L10P_T1_34); also elsewhere on the board
PL_B34_L11_N: U6.U15 (IO_L11N_T1_SRCC_34); also elsewhere on the board
PL_B34_L11_P: U6.U14 (IO_L11P_T1_SRCC_34); also elsewhere on the board
PL_B34_L14_N: U6.P20 (IO_L14N_T2_SRCC_34); also elsewhere on the board
PL_B34_L14_P: U6.N20 (IO_L14P_T2_SRCC_34); also elsewhere on the board
PL_B34_L15_N: U6.U20 (IO_L15N_T2_DQS_34); also elsewhere on the board
PL_B34_L15_P: U6.T20 (IO_L15P_T2_DQS_34); also elsewhere on the board
PL_B34_L16_N: U6.W20 (IO_L16N_T2_34); also elsewhere on the board
PL_B34_L16_P: U6.V20 (IO_L16P_T2_34); also elsewhere on the board
PL_B34_L17_N: U6.Y19 (IO_L17N_T2_34); also elsewhere on the board
PL_B34_L17_P: U6.Y18 (IO_L17P_T2_34); also elsewhere on the board
PL_B34_L18_N: U6.W16 (IO_L18N_T2_34); also elsewhere on the board
PL_B34_L18_P: U6.V16 (IO_L18P_T2_34); also elsewhere on the board
PL_B34_L22_N: U6.W19 (IO_L22N_T3_34); also elsewhere on the board
PL_B34_L22_P: U6.W18 (IO_L22P_T3_34); also elsewhere on the board
PL_B35_IO25: U6.J15 (IO_25_35); also elsewhere on the board
PL_B35_L3_N: U6.D18 (IO_L3N_T0_DQS_AD1N_35); also elsewhere on the board
PL_B35_L3_P: U6.E17 (IO_L3P_T0_DQS_AD1P_35); also elsewhere on the board
PL_B35_L5_N: U6.E19 (IO_L5N_T0_AD9N_35); also elsewhere on the board
PL_B35_L5_P: U6.E18 (IO_L5P_T0_AD9P_35); also elsewhere on the board
PL_B35_L6_N: U6.F17 (IO_L6N_T0_VREF_35); also elsewhere on the board
PL_B35_L6_P: U6.F16 (IO_L6P_T0_35); also elsewhere on the board
PL_B35_L7_N: U6.M20 (IO_L7N_T1_AD2N_35); also elsewhere on the board
PL_B35_L7_P: U6.M19 (IO_L7P_T1_AD2P_35); also elsewhere on the board
PL_B35_L8_N: U6.M18 (IO_L8N_T1_AD10N_35); also elsewhere on the board
PL_B35_L8_P: U6.M17 (IO_L8P_T1_AD10P_35); also elsewhere on the board
PL_B35_L9_N: U6.L20 (IO_L9N_T1_DQS_AD3N_35); also elsewhere on the board
PL_B35_L9_P: U6.L19 (IO_L9P_T1_DQS_AD3P_35); also elsewhere on the board
PL_B35_L11_N: U6.L17 (IO_L11N_T1_SRCC_35); also elsewhere on the board
PL_B35_L13_N: U6.H17 (IO_L13N_T2_MRCC_35); also elsewhere on the board
PL_B35_L13_P: U6.H16 (IO_L13P_T2_MRCC_35); also elsewhere on the board
PL_B35_L14_N: U6.H18 (IO_L14N_T2_AD4N_SRCC_35); also elsewhere on the board
PL_B35_L14_P: U6.J18 (IO_L14P_T2_AD4P_SRCC_35); also elsewhere on the board
PL_B35_L16_N: U6.G18 (IO_L16N_T2_35); also elsewhere on the board
PL_B35_L16_P: U6.G17 (IO_L16P_T2_35); also elsewhere on the board
PL_B35_L20_N: U6.J14 (IO_L20N_T3_AD6N_35); also elsewhere on the board
PL_B35_L20_P: U6.K14 (IO_L20P_T3_AD6P_35); also elsewhere on the board
PL_B35_L22_N: U6.L15 (IO_L22N_T3_AD7N_35); also elsewhere on the board
PL_B35_L22_P: U6.L14 (IO_L22P_T3_AD7P_35); also elsewhere on the board
PL_B35_L23_N: U6.M15 (IO_L23N_T3_35); also elsewhere on the board
PL_B35_L23_P: U6.M14 (IO_L23P_T3_35); also elsewhere on the board
PL_B35_L24_N: U6.J16 (IO_L24N_T3_AD15N_35); also elsewhere on the board
PL_CLK_125MHZ: U6.K17 (IO_L12P_T1_MRCC_35); also elsewhere on the board

Notes on the sheet:
Bank 35
BANK34
Diff Pair
Bank 34
BANK35
