findasifrahman/zynq_soc_board_v1/zynq_soc_board_v1.kicad_pcb

## KiCad design zynq_soc_board_v1.kicad_pcb (continued)

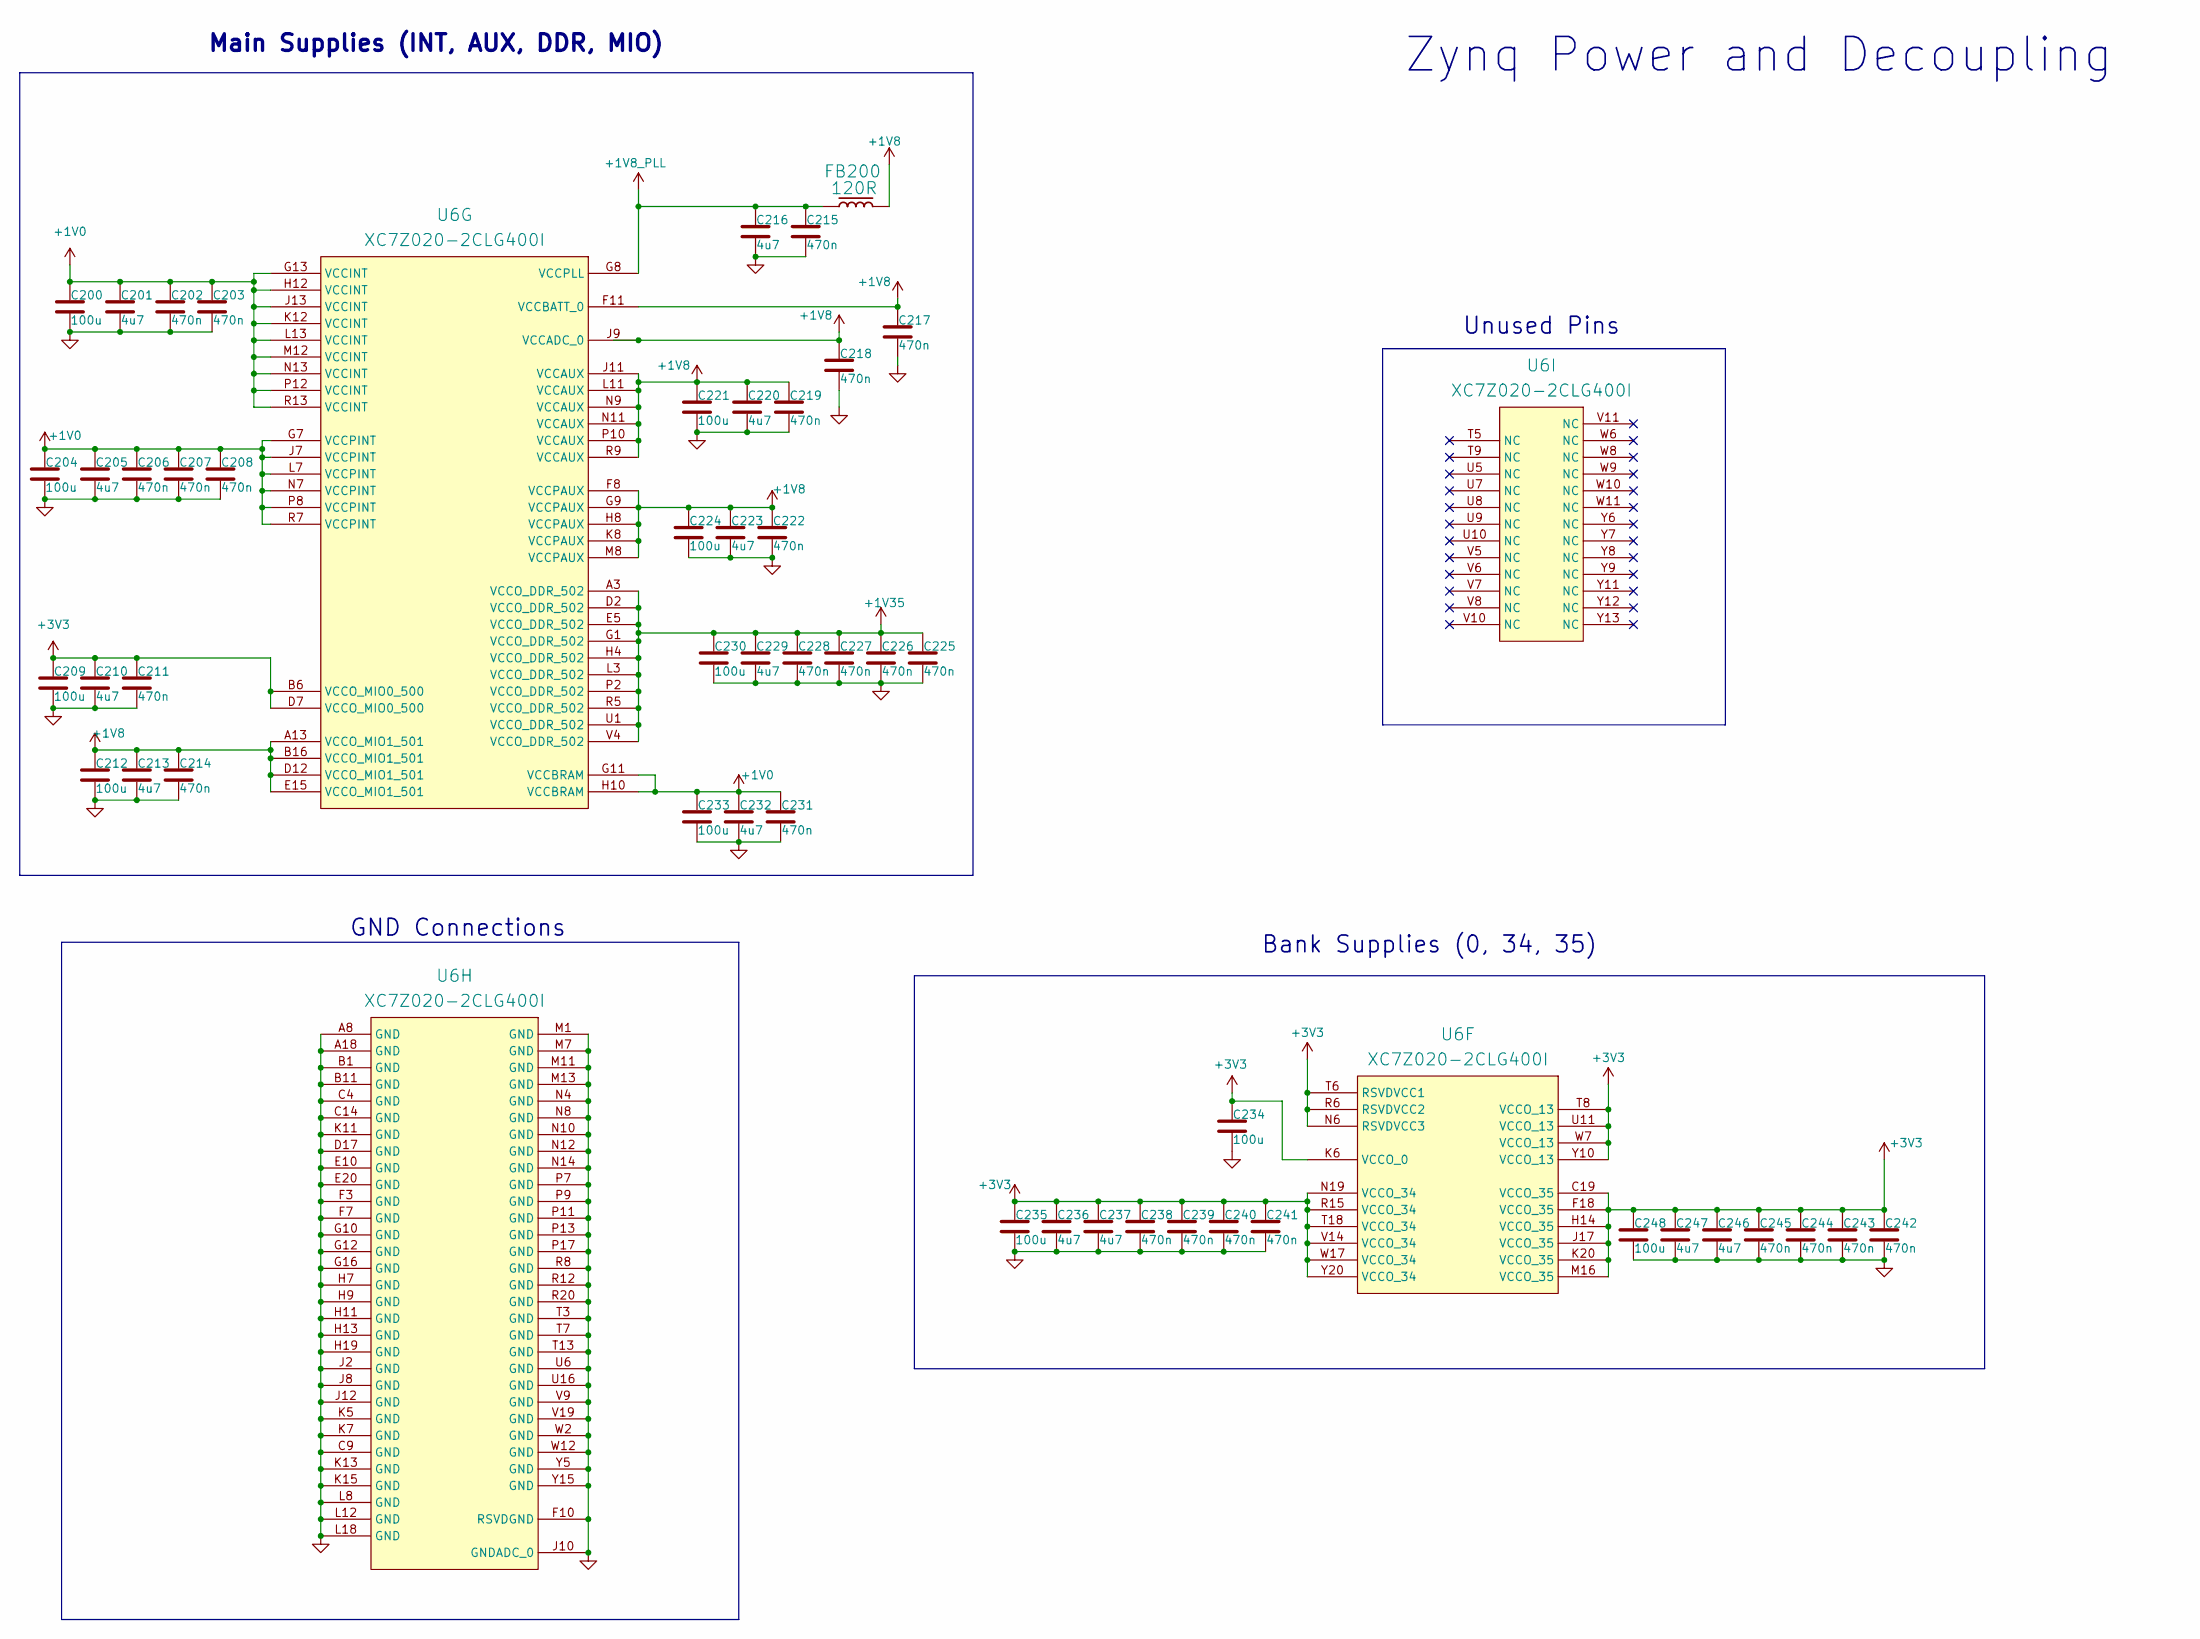
[picture p9: schematic zynq_power.kicad_sch, Zynq Power and Decoupling]

Parts:
C200, C204, C209, C212, C221, C224, C230, C233, C234, C235, C248: 100u; C_1206_3216Metric; Manufacturer Part Number CL31A107MQHNNNE; LCSC C15008
C201, C205, C210, C213, C216, C220, C223, C229, C232, C236, C237, C246, C247: 4u7; C_0402_1005Metric; Manufacturer Part Number CL05A475MP5NRNC; LCSC C23733
C202, C203, C206, C207, C208, C211, C214, C215, C217, C218, C219, C222, C225, C226, C227, C228, C231, C238, C239, C240, C241, C242, C243, C244, C245: 470n; C0201; Manufacturer Part Number C0603X5R1A474MT00NE; LCSC C76591
FB200: 120R; FB_0402; Manufacturer Part Number GZ1005D121TF; LCSC C38480
U6: XC7Z020-2CLG400I; Xilinx_CLG400; PartNumber XC7Z010-1CLG400C; LCSC C569043

Connections:
+1V0: C200.1, C201.1, C202.1, C203.1, C204.1, C205.1, C206.1, C207.1, C208.1, C231.1, C232.1, C233.1, U6.G7 (VCCPINT), U6.G11 (VCCBRAM), U6.G13 (VCCINT), U6.H10 (VCCBRAM), U6.H12 (VCCINT), U6.J7 (VCCPINT), U6.J13 (VCCINT), U6.K12 (VCCINT), U6.L7 (VCCPINT), U6.L13 (VCCINT), U6.M12 (VCCINT), U6.N7 (VCCPINT), U6.N13 (VCCINT), U6.P8 (VCCPINT), U6.P12 (VCCINT), U6.R7 (VCCPINT), U6.R13 (VCCINT); also elsewhere on the board
+1V8: C212.1, C213.1, C214.1, C217.1, C218.1, C219.1, C220.1, C221.1, C222.1, C223.1, C224.1, FB200.2, U6.A13 (VCCO_MIO1_501), U6.B16 (VCCO_MIO1_501), U6.D12 (VCCO_MIO1_501), U6.E15 (VCCO_MIO1_501), U6.F8 (VCCPAUX), U6.F11 (VCCBATT_0), U6.G9 (VCCPAUX), U6.H8 (VCCPAUX), U6.J9 (VCCADC_0), U6.J11 (VCCAUX), U6.K8 (VCCPAUX), U6.L11 (VCCAUX), U6.M8 (VCCPAUX), U6.N9 (VCCAUX), U6.N11 (VCCAUX), U6.P10 (VCCAUX), U6.R9 (VCCAUX); also elsewhere on the board
+1V8_PLL: C215.1, C216.1, FB200.1, U6.G8 (VCCPLL)
+1V35: C225.1, C226.1, C227.1, C228.1, C229.1, C230.1, U6.A3 (VCCO_DDR_502), U6.D2 (VCCO_DDR_502), U6.E5 (VCCO_DDR_502), U6.G1 (VCCO_DDR_502), U6.H4 (VCCO_DDR_502), U6.L3 (VCCO_DDR_502), U6.P2 (VCCO_DDR_502), U6.R5 (VCCO_DDR_502), U6.U1 (VCCO_DDR_502), U6.V4 (VCCO_DDR_502); also elsewhere on the board
+3V3: C209.1, C210.1, C211.1, C234.1, C235.1, C236.1, C237.1, C238.1, C239.1, C240.1, C241.1, C242.1, C243.1, C244.1, C245.1, C246.1, C247.1, C248.1, U6.B6 (VCCO_MIO0_500), U6.C19 (VCCO_35), U6.D7 (VCCO_MIO0_500), U6.F18 (VCCO_35), U6.H14 (VCCO_35), U6.J17 (VCCO_35), U6.K6 (VCCO_0), U6.K20 (VCCO_35), U6.M16 (VCCO_35), U6.N6 (RSVDVCC3), U6.N19 (VCCO_34), U6.R6 (RSVDVCC2), U6.R15 (VCCO_34), U6.T6 (RSVDVCC1), U6.T8 (VCCO_13), U6.T18 (VCCO_34), U6.U11 (VCCO_13), U6.V14 (VCCO_34), U6.W7 (VCCO_13), U6.W17 (VCCO_34), U6.Y10 (VCCO_13), U6.Y20 (VCCO_34); also elsewhere on the board
GND: C200.2, C201.2, C202.2, C203.2, C204.2, C205.2, C206.2, C207.2, C208.2, C209.2, C210.2, C211.2, C212.2, C213.2, C214.2, C215.2, C216.2, C217.2, C218.2, C219.2, C220.2, C221.2, C222.2, C223.2, C224.2, C225.2, C226.2, C227.2, C228.2, C229.2, C230.2, C231.2, C232.2, C233.2, C234.2, C235.2, C236.2, C237.2, C238.2, C239.2, C240.2, C241.2, C242.2, C243.2, C244.2, C245.2, C246.2, C247.2, C248.2, U6.A8 (GND), U6.A18 (GND), U6.B1 (GND), U6.B11 (GND), U6.C4 (GND), U6.C9 (GND), U6.C14 (GND), U6.D17 (GND), U6.E10 (GND), U6.E20 (GND), U6.F3 (GND), U6.F7 (GND), U6.F10 (RSVDGND), U6.G10 (GND), U6.G12 (GND), U6.G16 (GND), U6.H7 (GND), U6.H9 (GND), U6.H11 (GND), U6.H13 (GND), U6.H19 (GND), U6.J2 (GND), U6.J8 (GND), U6.J10 (GNDADC_0), U6.J12 (GND), U6.K5 (GND), U6.K7 (GND), U6.K11 (GND), U6.K13 (GND), U6.K15 (GND), U6.L8 (GND), U6.L12 (GND), U6.L18 (GND), U6.M1 (GND), U6.M7 (GND), U6.M11 (GND), U6.M13 (GND), U6.N4 (GND), U6.N8 (GND), U6.N10 (GND), U6.N12 (GND), U6.N14 (GND), U6.P7 (GND), U6.P9 (GND), U6.P11 (GND), U6.P13 (GND), U6.P17 (GND), U6.R8 (GND), U6.R12 (GND), U6.R20 (GND), U6.T3 (GND), U6.T7 (GND), U6.T13 (GND), U6.U6 (GND), U6.U16 (GND), U6.V9 (GND), U6.V19 (GND), U6.W2 (GND), U6.W12 (GND), U6.Y5 (GND), U6.Y15 (GND); also elsewhere on the board

Notes on the sheet:
Main Supplies (INT, AUX, DDR, MIO)
GND Connections
Unused Pins
Zynq Power and Decoupling
Bank Supplies (0, 34, 35)

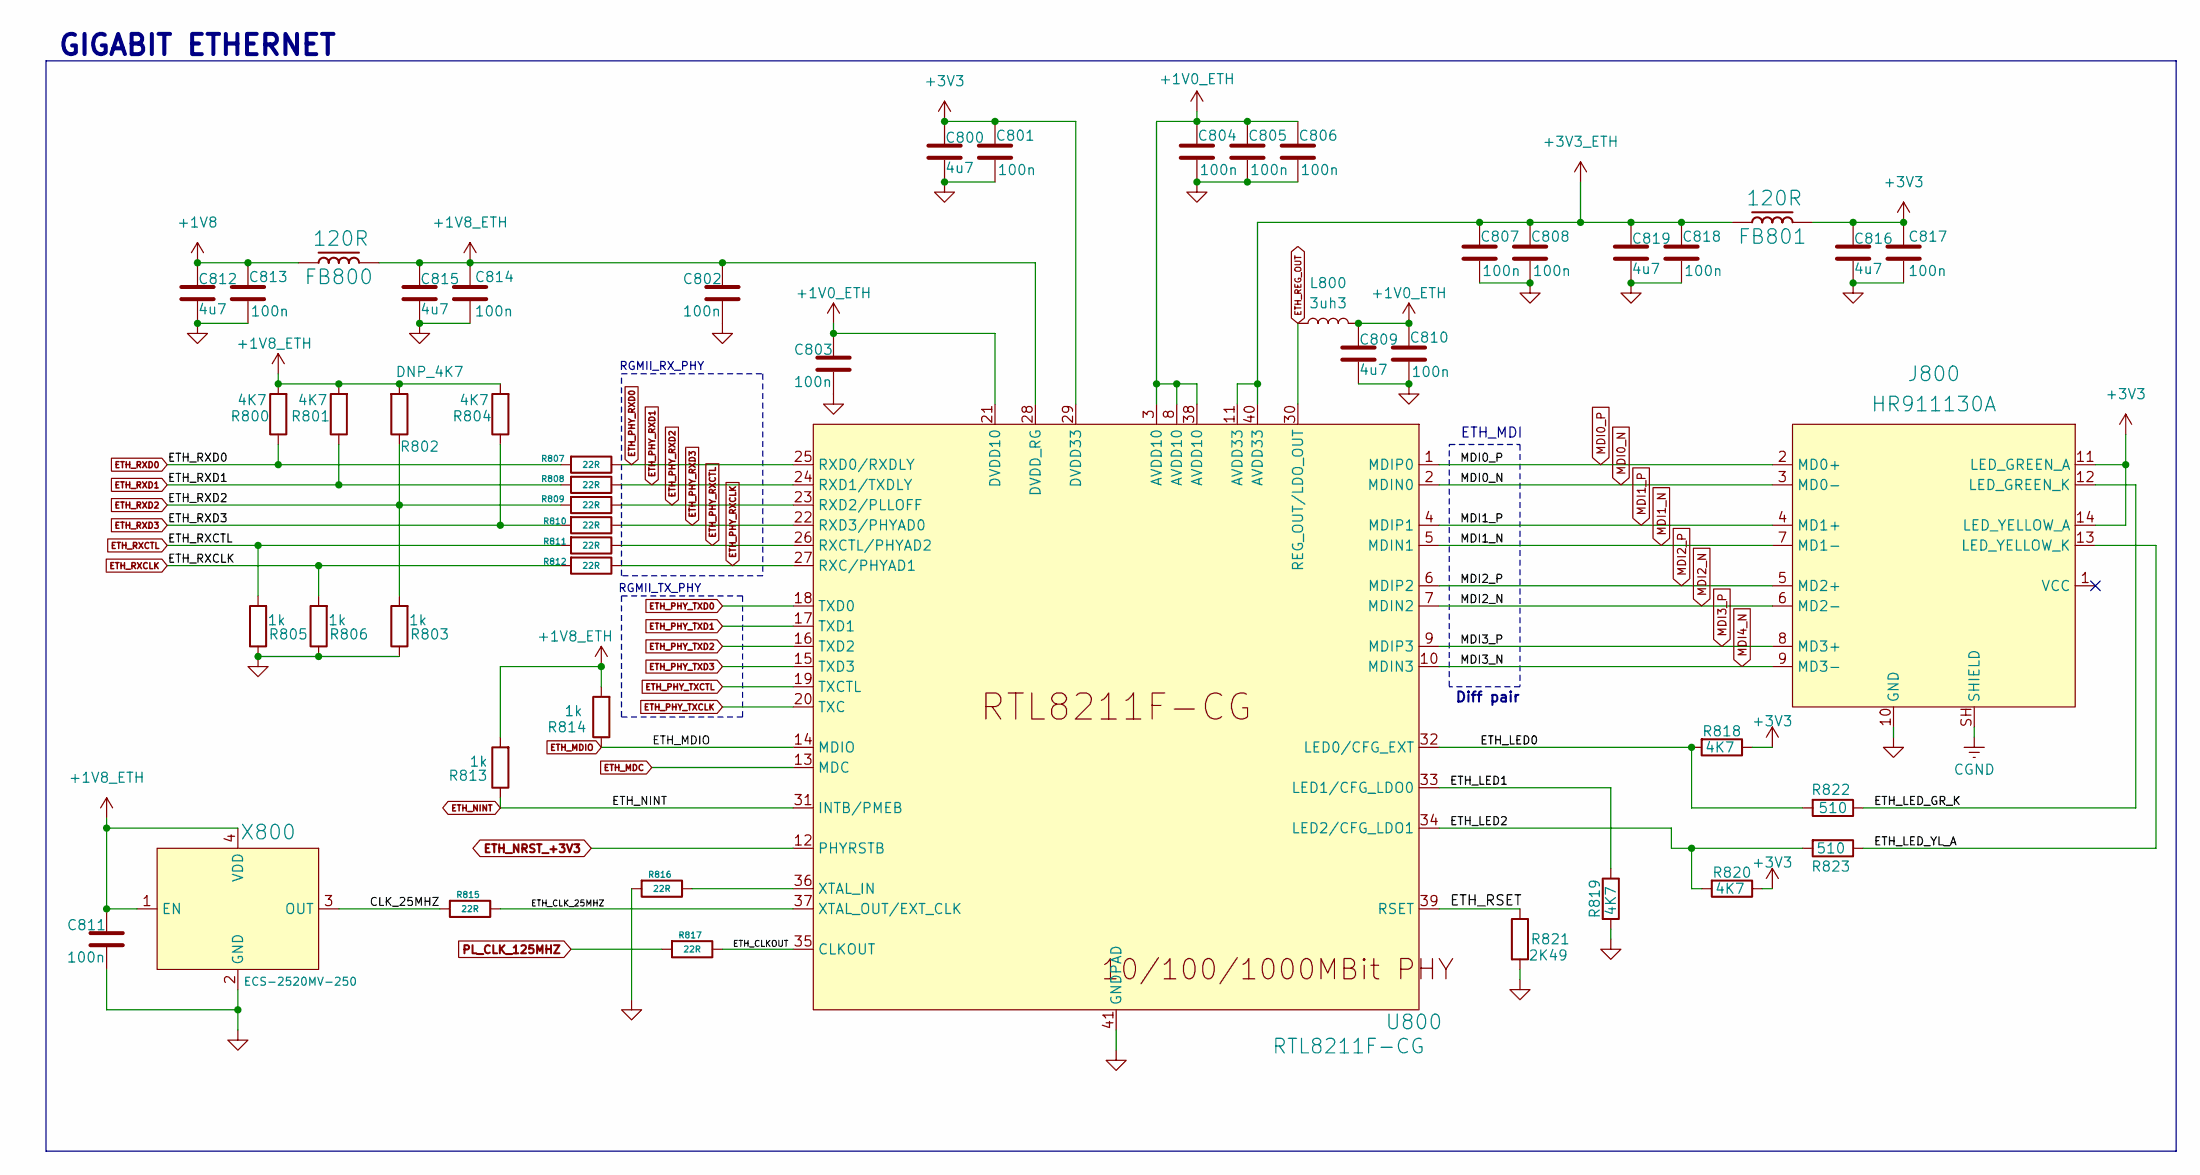
[picture p10: schematic ethernet.kicad_sch, (text "GIGABIT ETHERNET" (exclude_from_sim no)]

Parts:
C800, C809, C812, C815, C816, C819: 4u7; C_0402_1005Metric; Manufacturer Part Number CL05A475MP5NRNC; LCSC C23733
C801, C802, C803, C804, C805, C806, C807, C808, C810, C811, C813, C814, C817, C818: 100n; C_0402_1005Metric; Manufacturer Part Number CL05B104KO5NNNC; LCSC C1525
FB800, FB801: 120R; FB_0402; Manufacturer Part Number GZ1005D121TF; LCSC C38480
J800: HR911130A; Manufacturer Part Number HR911130A; LCSC C54408
L800: 3uh3; L_0603_1608Metric; Manufacturer Part Number LQM18PN3R3MFRL; LCSC C162581
R800, R801, R804, R818, R819, R820: 4K7; R_0402_1005Metric; Manufacturer Part Number 0402WGF4701TCE; LCSC C25900
R802: DNP_4K7; R_0402_1005Metric
R803, R805, R806, R813, R814: 1k; R_0402_1005Metric; Manufacturer Part Number 0402WGF1001TCE; LCSC C11702
R807, R808, R809, R810, R811, R812, R815, R816, R817: 22R; R_0402_1005Metric; Manufacturer Part Number 0402WGF220JTCE; LCSC C25092
R821: 2K49; R_0402_1005Metric; Manufacturer Part Number 0402WGF2491TCE; LCSC C25884
R822, R823: 510; R_0402_1005Metric; Manufacturer Part Number RC-02W511JT; LCSC C1119
U800: RTL8211F-CG; WQFN-40_L5.0-W5.0-P0.4-BL-EP; Manufacturer Part Number RTL8211F-CG; LCSC C187932
X800: ECS-2520MV-250; XTAL_2520; Manufacturer Part Number ECS-2520MV-250-BN-TR; LCSC C405463

Connections:
+1V0_ETH: C803.1, C804.1, C805.1, C806.1, C809.1, C810.1, L800.2, U800.3 (AVDD10), U800.8 (AVDD10), U800.21 (DVDD10), U800.38 (AVDD10)
+1V8: C812.1, C813.1, FB800.1; also elsewhere on the board
+1V8_ETH: C802.1, C811.1, C814.1, C815.1, FB800.2, R800.2, R801.2, R802.2, R804.2, R813.2, R814.2, U800.28 (DVDD_RG), X800.1 (EN), X800.4 (VDD)
+3V3: C800.1, C801.1, C816.1, C817.1, FB801.2, J800.11 (LED_GREEN_A), J800.14 (LED_YELLOW_A), R818.1, R820.1, U800.29 (DVDD33); also elsewhere on the board
+3V3_ETH: C807.1, C808.1, C818.1, C819.1, FB801.1, U800.11 (AVDD33), U800.40 (AVDD33)
/ethernet_gigabit/CLK_25MHZ: R815.2, X800.3 (OUT)
/ethernet_gigabit/ETH_CLKOUT: R817.1, U800.35 (CLKOUT)
/ethernet_gigabit/ETH_CLK_25MHZ: R815.1, U800.37 (XTAL_OUT/EXT_CLK)
/ethernet_gigabit/ETH_LED0: R818.2, R822.2, U800.32 (LED0/CFG_EXT)
/ethernet_gigabit/ETH_LED1: R819.1, U800.33 (LED1/CFG_LDO0)
/ethernet_gigabit/ETH_LED2: R820.2, R823.2, U800.34 (LED2/CFG_LDO1)
/ethernet_gigabit/ETH_LED_GR_K: J800.12 (LED_GREEN_K), R822.1
/ethernet_gigabit/ETH_LED_YL_A: J800.13 (LED_YELLOW_K), R823.1
/ethernet_gigabit/ETH_RSET: R821.1, U800.39 (RSET)
CGND: J800.SH (SHIELD); also elsewhere on the board
ETH_MDC: U800.13 (MDC); also elsewhere on the board
ETH_MDIO: R814.1, U800.14 (MDIO); also elsewhere on the board
ETH_NINT: R813.1, U800.31 (INTB/PMEB); also elsewhere on the board
ETH_NRST_+3V3: U800.12 (PHYRSTB); also elsewhere on the board
ETH_PHY_RXCLK: R812.1, U800.27 (RXC/PHYAD1)
ETH_PHY_RXCTL: R811.1, U800.26 (RXCTL/PHYAD2)
ETH_PHY_RXD0: R807.1, U800.25 (RXD0/RXDLY)
ETH_PHY_RXD1: R808.1, U800.24 (RXD1/TXDLY)
ETH_PHY_RXD2: R809.1, U800.23 (RXD2/PLLOFF)
ETH_PHY_RXD3: R810.1, U800.22 (RXD3/PHYAD0)
ETH_PHY_TXCLK: U800.20 (TXC); also elsewhere on the board
ETH_PHY_TXCTL: U800.19 (TXCTL); also elsewhere on the board
ETH_PHY_TXD0: U800.18 (TXD0); also elsewhere on the board
ETH_PHY_TXD1: U800.17 (TXD1); also elsewhere on the board
ETH_PHY_TXD2: U800.16 (TXD2); also elsewhere on the board
ETH_PHY_TXD3: U800.15 (TXD3); also elsewhere on the board
ETH_REG_OUT: L800.1, U800.30 (REG_OUT/LDO_OUT)
ETH_RXCLK: R806.2, R812.2; also elsewhere on the board
ETH_RXCTL: R805.2, R811.2; also elsewhere on the board
ETH_RXD0: R800.1, R807.2; also elsewhere on the board
ETH_RXD1: R801.1, R808.2; also elsewhere on the board
ETH_RXD2: R802.1, R803.2, R809.2; also elsewhere on the board
ETH_RXD3: R804.1, R810.2; also elsewhere on the board
GND: C800.2, C801.2, C802.2, C803.2, C804.2, C805.2, C806.2, C807.2, C808.2, C809.2, C810.2, C811.2, C812.2, C813.2, C814.2, C815.2, C816.2, C817.2, C818.2, C819.2, J800.10 (GND), R803.1, R805.1, R806.1, R816.2, R819.2, R821.2, U800.41 (GNDPAD), X800.2 (GND); also elsewhere on the board
MDI0_N: J800.3 (MD0-), U800.2 (MDIN0)
MDI0_P: J800.2 (MD0+), U800.1 (MDIP0)
MDI1_N: J800.7 (MD1-), U800.5 (MDIN1)
MDI1_P: J800.4 (MD1+), U800.4 (MDIP1)
MDI2_N: J800.6 (MD2-), U800.7 (MDIN2)
MDI2_P: J800.5 (MD2+), U800.6 (MDIP2)
MDI3_P: J800.8 (MD3+), U800.9 (MDIP3)
MDI4_N: J800.9 (MD3-), U800.10 (MDIN3)
unnamed: R816.1, U800.36 (XTAL_IN)
PL_CLK_125MHZ: R817.2; also elsewhere on the board

Notes on the sheet:
ETH_MDI
Diff pair
RGMII_TX_PHY
GIGABIT ETHERNET
RGMII_RX_PHY

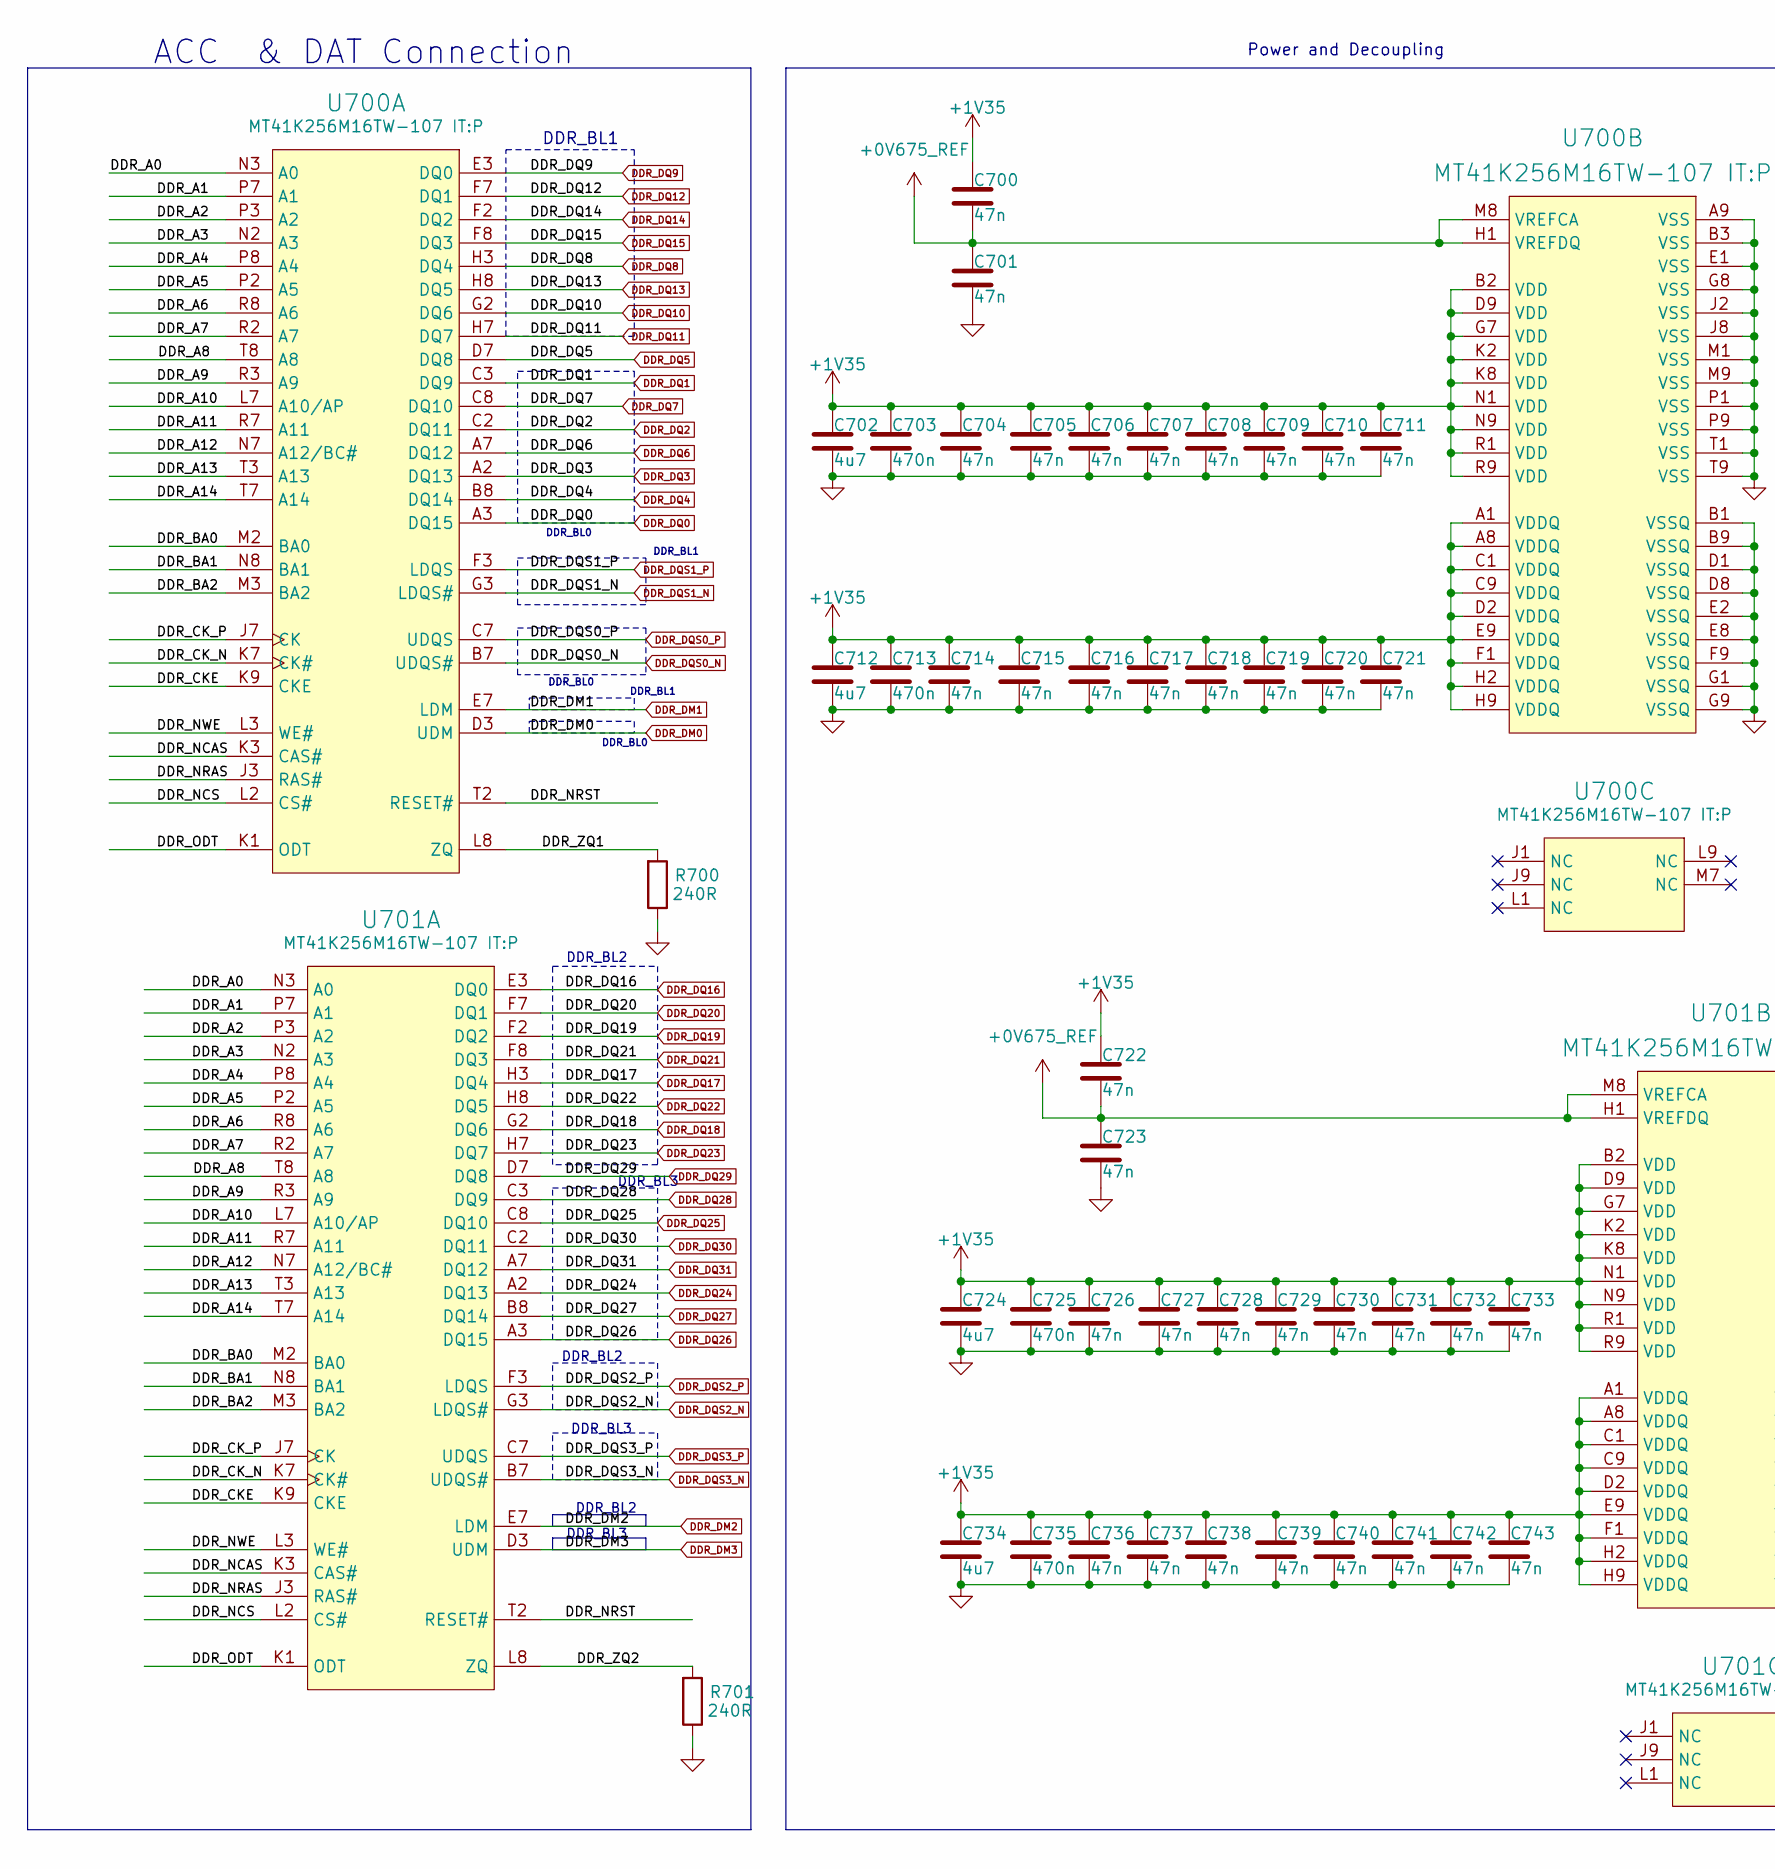
[picture p11: schematic zynq_ddr.kicad_sch, Zynq DDR Interface & 1GB DDR3L Modules, part in row 1, column 1]

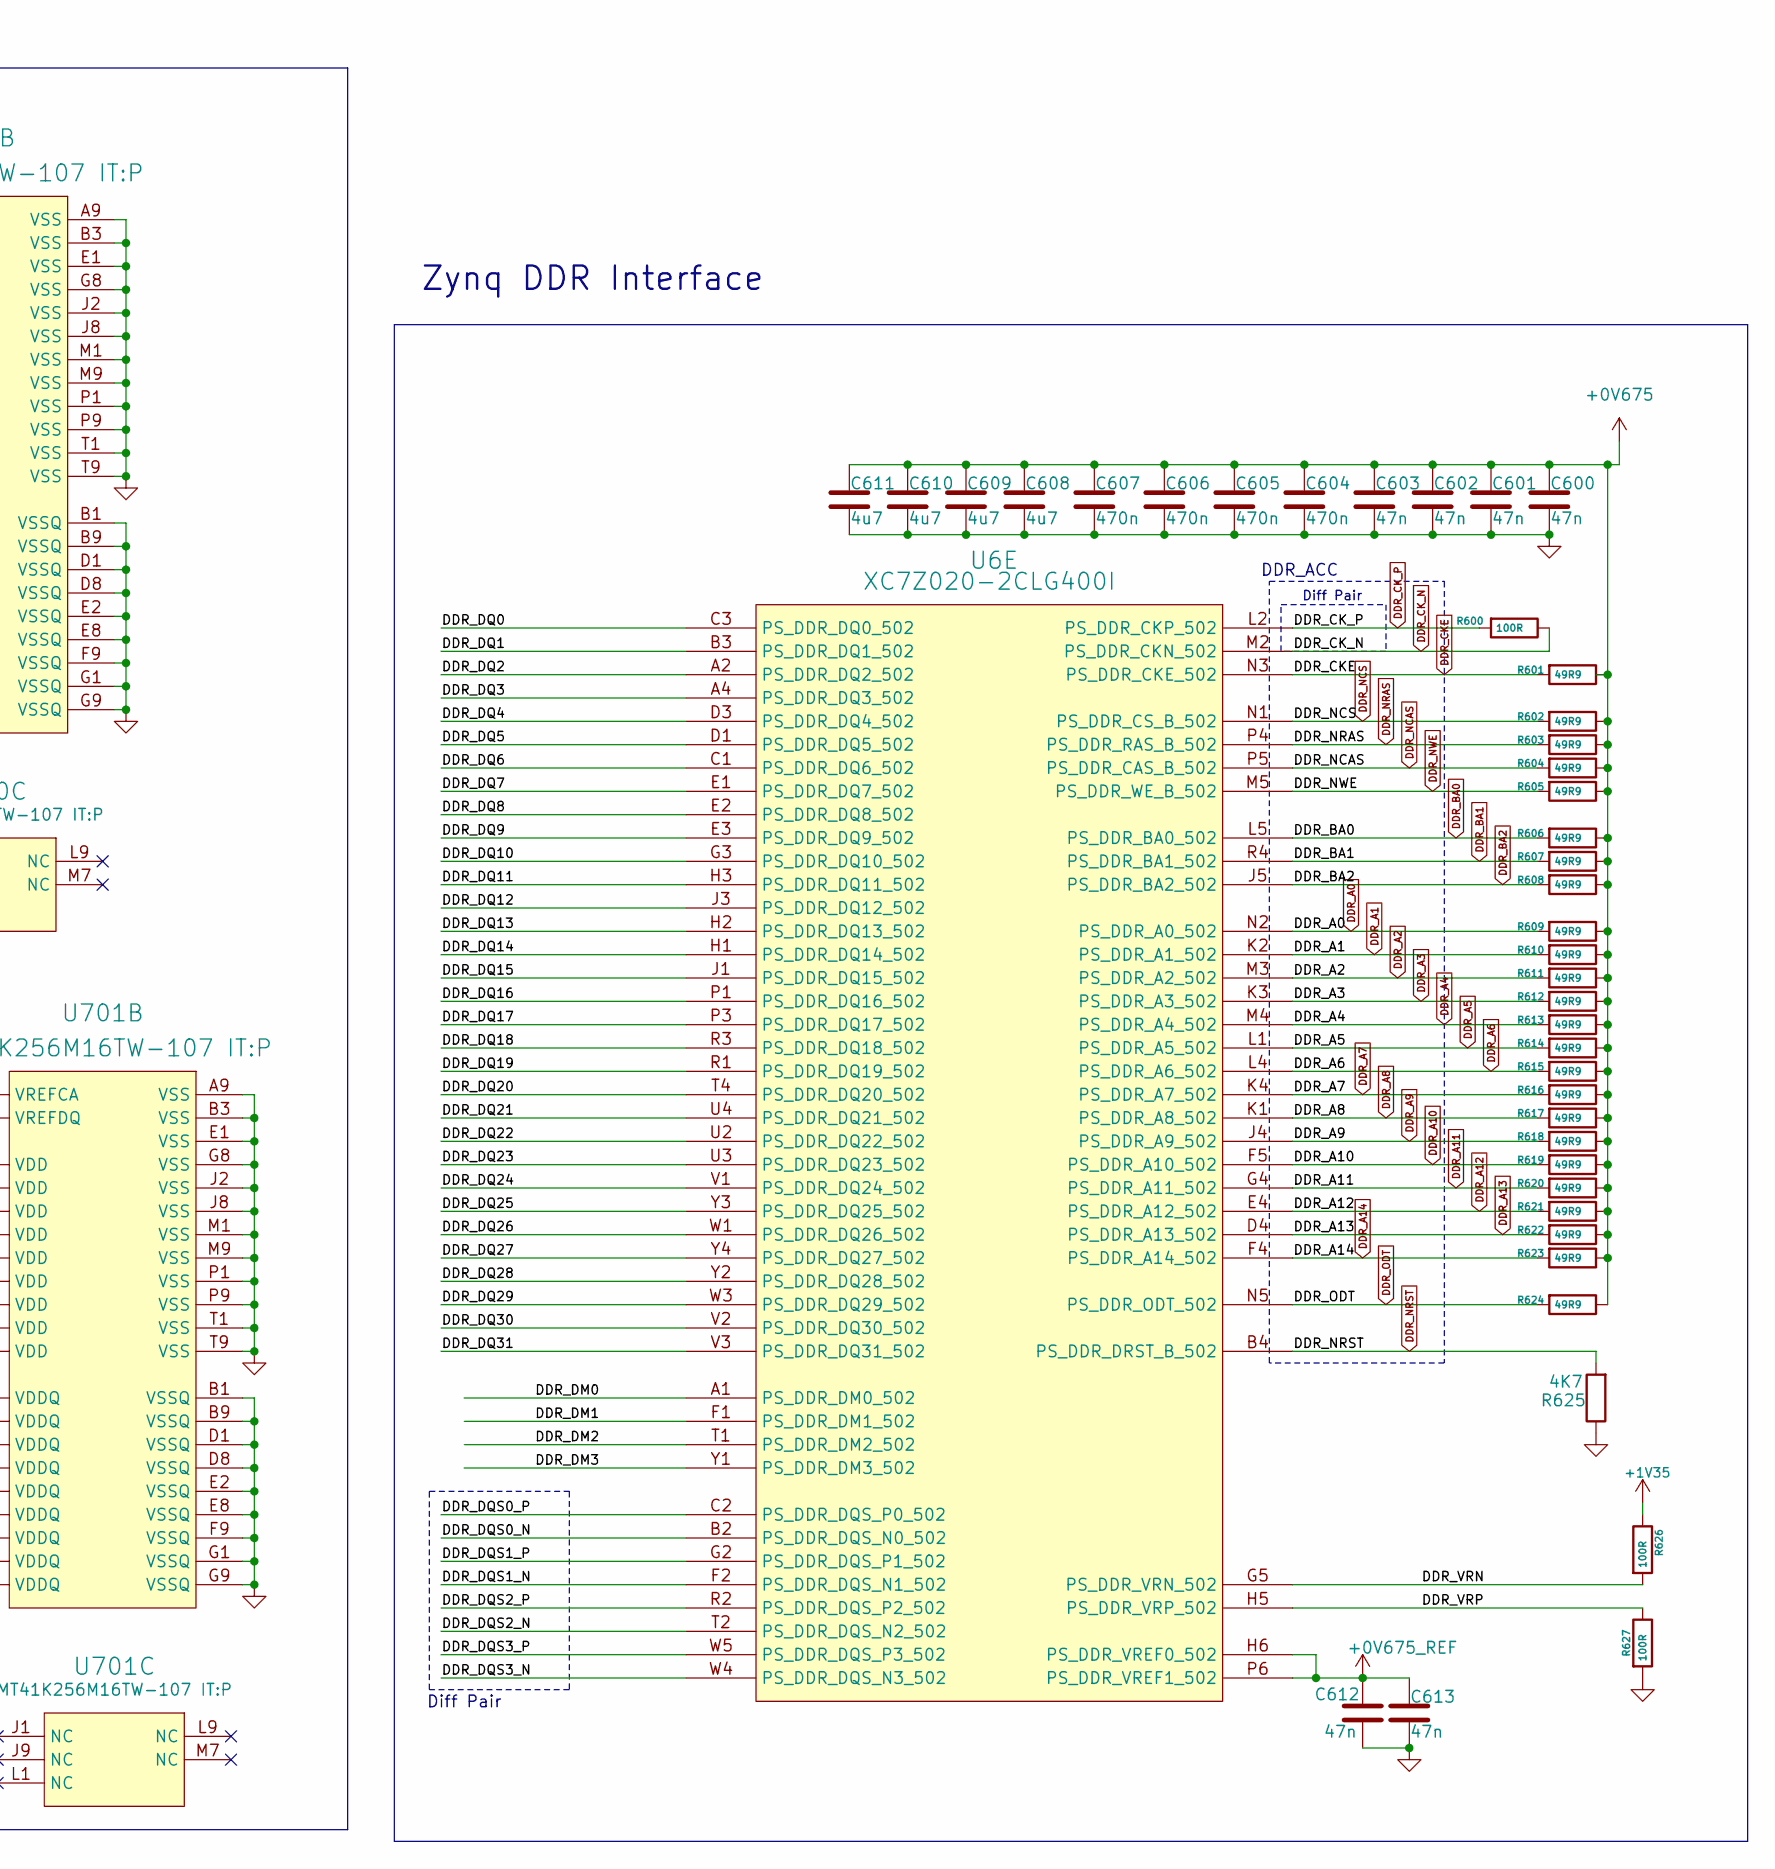
[picture p12: schematic zynq_ddr.kicad_sch, Zynq DDR Interface & 1GB DDR3L Modules, part in row 1, column 2]

Parts:
C600, C601, C602, C603, C612, C613, C700, C701, C704, C705, C706, C707, C708, C709, C710, C711, C714, C715, C716, C717, C718, C719, C720, C721, C722, C723: 47n; C0201; Manufacturer Part Number GRM033R61C473KE84D; LCSC C88917
C604, C605, C606, C607, C703, C713: 470n; C0201; Manufacturer Part Number C0603X5R1A474MT00NE; LCSC C76591
C608, C609, C610, C611, C702, C724, C734: 4u7; C_0402_1005Metric; Manufacturer Part Number CL05A475MP5NRNC; LCSC C23733
C712: 4u7; C0201; Manufacturer Part Number CL05A475MP5NRNC; LCSC C23733
C725, C735: 470n; C_0201_0603Metric; Manufacturer Part Number C0603X5R1A474MT00NE; LCSC C76591
C726, C727, C728, C729, C730, C731, C732, C733, C736, C737, C738, C739, C740, C741, C742, C743: 47n; C_0201_0603Metric; Manufacturer Part Number GRM033R61C473KE84D; LCSC C88917
R600, R626, R627: 100R; R0201; Manufacturer Part Number RC0201FR-07100RL; LCSC C77623
R601, R602, R603, R604, R605, R606, R607, R608, R609, R610, R611, R612, R613, R614, R615, R616, R617, R618, R619, R620, R621, R622, R623, R624: 49R9; R0201; Manufacturer Part Number RC0201FR-0749R9L; LCSC C155744
R625: 4K7; R_0402_1005Metric; Manufacturer Part Number 0402WGF4701TCE; LCSC C25900
R700, R701: 240R; R_0402_1005Metric; Manufacturer Part Number 0402WGF2400TCE; LCSC C25094
U6: XC7Z020-2CLG400I; Xilinx_CLG400; PartNumber XC7Z010-1CLG400C; LCSC C569043
U700, U701: MT41K256M16TW-107 IT:P; FBGA-96_L14.0-W8.0-R16-C6-P0.80-TL; Manufacturer Part Number MT41K256M16TW-107 IT:P; LCSC C367428

Connections:
+0V675: C600.1, C601.1, C602.1, C603.1, C604.1, C605.1, C606.1, C607.1, C608.1, C609.1, C610.1, C611.1, R601.1, R602.1, R603.1, R604.1, R605.1, R606.1, R607.1, R608.1, R609.1, R610.1, R611.1, R612.1, R613.1, R614.1, R615.1, R616.1, R617.1, R618.1, R619.1, R620.1, R621.1, R622.1, R623.1, R624.1; also elsewhere on the board
+0V675_REF: C612.1, C613.1, C700.2, C701.1, C722.2, C723.1, U6.H6 (PS_DDR_VREF0_502), U6.P6 (PS_DDR_VREF1_502), U700.H1 (VREFDQ), U700.M8 (VREFCA), U701.H1 (VREFDQ), U701.M8 (VREFCA); also elsewhere on the board
+1V35: C700.1, C702.1, C703.1, C704.1, C705.1, C706.1, C707.1, C708.1, C709.1, C710.1, C711.1, C712.1, C713.1, C714.1, C715.1, C716.1, C717.1, C718.1, C719.1, C720.1, C721.1, C722.1, C724.1, C725.1, C726.1, C727.1, C728.1, C729.1, C730.1, C731.1, C732.1, C733.1, C734.1, C735.1, C736.1, C737.1, C738.1, C739.1, C740.1, C741.1, C742.1, C743.1, R626.1, U700.A1 (VDDQ), U700.A8 (VDDQ), U700.B2 (VDD), U700.C1 (VDDQ), U700.C9 (VDDQ), U700.D2 (VDDQ), U700.D9 (VDD), U700.E9 (VDDQ), U700.F1 (VDDQ), U700.G7 (VDD), U700.H2 (VDDQ), U700.H9 (VDDQ), U700.K2 (VDD), U700.K8 (VDD), U700.N1 (VDD), U700.N9 (VDD), U700.R1 (VDD), U700.R9 (VDD), U701.A1 (VDDQ), U701.A8 (VDDQ), U701.B2 (VDD), U701.C1 (VDDQ), U701.C9 (VDDQ), U701.D2 (VDDQ), U701.D9 (VDD), U701.E9 (VDDQ), U701.F1 (VDDQ), U701.G7 (VDD), U701.H2 (VDDQ), U701.H9 (VDDQ), U701.K2 (VDD), U701.K8 (VDD), U701.N1 (VDD), U701.N9 (VDD), U701.R1 (VDD), U701.R9 (VDD); also elsewhere on the board
/zynq_ddr/DDR_VRN: R626.2, U6.G5 (PS_DDR_VRN_502)
/zynq_ddr/DDR_VRP: R627.1, U6.H5 (PS_DDR_VRP_502)
/zynq_ddr/DDR_ZQ1: R700.2, U700.L8 (ZQ)
/zynq_ddr/DDR_ZQ2: R701.2, U701.L8 (ZQ)
DDR_A0: R609.2, U6.N2 (PS_DDR_A0_502), U700.N3 (A0), U701.N3 (A0)
DDR_A1: R610.2, U6.K2 (PS_DDR_A1_502), U700.P7 (A1), U701.P7 (A1)
DDR_A2: R611.2, U6.M3 (PS_DDR_A2_502), U700.P3 (A2), U701.P3 (A2)
DDR_A3: R612.2, U6.K3 (PS_DDR_A3_502), U700.N2 (A3), U701.N2 (A3)
DDR_A4: R613.2, U6.M4 (PS_DDR_A4_502), U700.P8 (A4), U701.P8 (A4)
DDR_A5: R614.2, U6.L1 (PS_DDR_A5_502), U700.P2 (A5), U701.P2 (A5)
DDR_A6: R615.2, U6.L4 (PS_DDR_A6_502), U700.R8 (A6), U701.R8 (A6)
DDR_A7: R616.2, U6.K4 (PS_DDR_A7_502), U700.R2 (A7), U701.R2 (A7)
DDR_A8: R617.2, U6.K1 (PS_DDR_A8_502), U700.T8 (A8), U701.T8 (A8)
DDR_A9: R618.2, U6.J4 (PS_DDR_A9_502), U700.R3 (A9), U701.R3 (A9)
DDR_A10: R619.2, U6.F5 (PS_DDR_A10_502), U700.L7 (A10/AP), U701.L7 (A10/AP)
DDR_A11: R620.2, U6.G4 (PS_DDR_A11_502), U700.R7 (A11), U701.R7 (A11)
DDR_A12: R621.2, U6.E4 (PS_DDR_A12_502), U700.N7 (A12/BC#), U701.N7 (A12/BC#)
DDR_A13: R622.2, U6.D4 (PS_DDR_A13_502), U700.T3 (A13), U701.T3 (A13)
DDR_A14: R623.2, U6.F4 (PS_DDR_A14_502), U700.T7 (A14), U701.T7 (A14)
DDR_BA0: R606.2, U6.L5 (PS_DDR_BA0_502), U700.M2 (BA0), U701.M2 (BA0)
DDR_BA1: R607.2, U6.R4 (PS_DDR_BA1_502), U700.N8 (BA1), U701.N8 (BA1)
DDR_BA2: R608.2, U6.J5 (PS_DDR_BA2_502), U700.M3 (BA2), U701.M3 (BA2)
DDR_CKE: R601.2, U6.N3 (PS_DDR_CKE_502), U700.K9 (CKE), U701.K9 (CKE)
DDR_CK_N: R600.1, U6.M2 (PS_DDR_CKN_502), U700.K7 (CK#), U701.K7 (CK#)
DDR_CK_P: R600.2, U6.L2 (PS_DDR_CKP_502), U700.J7 (CK), U701.J7 (CK)
DDR_DM0: U6.A1 (PS_DDR_DM0_502), U700.D3 (UDM)
DDR_DM1: U6.F1 (PS_DDR_DM1_502), U700.E7 (LDM)
DDR_DM2: U6.T1 (PS_DDR_DM2_502), U701.E7 (LDM)
DDR_DM3: U6.Y1 (PS_DDR_DM3_502), U701.D3 (UDM)
DDR_DQ0: U6.C3 (PS_DDR_DQ0_502), U700.A3 (DQ15)
DDR_DQ1: U6.B3 (PS_DDR_DQ1_502), U700.C3 (DQ9)
DDR_DQ2: U6.A2 (PS_DDR_DQ2_502), U700.C2 (DQ11)
DDR_DQ3: U6.A4 (PS_DDR_DQ3_502), U700.A2 (DQ13)
DDR_DQ4: U6.D3 (PS_DDR_DQ4_502), U700.B8 (DQ14)
DDR_DQ5: U6.D1 (PS_DDR_DQ5_502), U700.D7 (DQ8)
DDR_DQ6: U6.C1 (PS_DDR_DQ6_502), U700.A7 (DQ12)
DDR_DQ7: U6.E1 (PS_DDR_DQ7_502), U700.C8 (DQ10)
DDR_DQ8: U6.E2 (PS_DDR_DQ8_502), U700.H3 (DQ4)
DDR_DQ9: U6.E3 (PS_DDR_DQ9_502), U700.E3 (DQ0)
DDR_DQ10: U6.G3 (PS_DDR_DQ10_502), U700.G2 (DQ6)
DDR_DQ11: U6.H3 (PS_DDR_DQ11_502), U700.H7 (DQ7)
DDR_DQ12: U6.J3 (PS_DDR_DQ12_502), U700.F7 (DQ1)
DDR_DQ13: U6.H2 (PS_DDR_DQ13_502), U700.H8 (DQ5)
DDR_DQ14: U6.H1 (PS_DDR_DQ14_502), U700.F2 (DQ2)
DDR_DQ15: U6.J1 (PS_DDR_DQ15_502), U700.F8 (DQ3)
DDR_DQ16: U6.P1 (PS_DDR_DQ16_502), U701.E3 (DQ0)
DDR_DQ17: U6.P3 (PS_DDR_DQ17_502), U701.H3 (DQ4)
DDR_DQ18: U6.R3 (PS_DDR_DQ18_502), U701.G2 (DQ6)
DDR_DQ19: U6.R1 (PS_DDR_DQ19_502), U701.F2 (DQ2)
DDR_DQ20: U6.T4 (PS_DDR_DQ20_502), U701.F7 (DQ1)
DDR_DQ21: U6.U4 (PS_DDR_DQ21_502), U701.F8 (DQ3)
DDR_DQ22: U6.U2 (PS_DDR_DQ22_502), U701.H8 (DQ5)
DDR_DQ23: U6.U3 (PS_DDR_DQ23_502), U701.H7 (DQ7)
DDR_DQ24: U6.V1 (PS_DDR_DQ24_502), U701.A2 (DQ13)
DDR_DQ25: U6.Y3 (PS_DDR_DQ25_502), U701.C8 (DQ10)
DDR_DQ26: U6.W1 (PS_DDR_DQ26_502), U701.A3 (DQ15)
DDR_DQ27: U6.Y4 (PS_DDR_DQ27_502), U701.B8 (DQ14)
DDR_DQ28: U6.Y2 (PS_DDR_DQ28_502), U701.C3 (DQ9)
DDR_DQ29: U6.W3 (PS_DDR_DQ29_502), U701.D7 (DQ8)
DDR_DQ30: U6.V2 (PS_DDR_DQ30_502), U701.C2 (DQ11)
DDR_DQ31: U6.V3 (PS_DDR_DQ31_502), U701.A7 (DQ12)
DDR_DQS0_N: U6.B2 (PS_DDR_DQS_N0_502), U700.B7 (UDQS#)
DDR_DQS0_P: U6.C2 (PS_DDR_DQS_P0_502), U700.C7 (UDQS)
DDR_DQS1_N: U6.F2 (PS_DDR_DQS_N1_502), U700.G3 (LDQS#)
DDR_DQS1_P: U6.G2 (PS_DDR_DQS_P1_502), U700.F3 (LDQS)
DDR_DQS2_N: U6.T2 (PS_DDR_DQS_N2_502), U701.G3 (LDQS#)
DDR_DQS2_P: U6.R2 (PS_DDR_DQS_P2_502), U701.F3 (LDQS)
DDR_DQS3_N: U6.W4 (PS_DDR_DQS_N3_502), U701.B7 (UDQS#)
DDR_DQS3_P: U6.W5 (PS_DDR_DQS_P3_502), U701.C7 (UDQS)
DDR_NCAS: R604.2, U6.P5 (PS_DDR_CAS_B_502), U700.K3 (CAS#), U701.K3 (CAS#)
DDR_NCS: R602.2, U6.N1 (PS_DDR_CS_B_502), U700.L2 (CS#), U701.L2 (CS#)
DDR_NRAS: R603.2, U6.P4 (PS_DDR_RAS_B_502), U700.J3 (RAS#), U701.J3 (RAS#)
DDR_NRST: R625.2, U6.B4 (PS_DDR_DRST_B_502), U700.T2 (RESET#), U701.T2 (RESET#)
DDR_NWE: R605.2, U6.M5 (PS_DDR_WE_B_502), U700.L3 (WE#), U701.L3 (WE#)
DDR_ODT: R624.2, U6.N5 (PS_DDR_ODT_502), U700.K1 (ODT), U701.K1 (ODT)
GND: C600.2, C601.2, C602.2, C603.2, C604.2, C605.2, C606.2, C607.2, C608.2, C609.2, C610.2, C611.2, C612.2, C613.2, C701.2, C702.2, C703.2, C704.2, C705.2, C706.2, C707.2, C708.2, C709.2, C710.2, C711.2, C712.2, C713.2, C714.2, C715.2, C716.2, C717.2, C718.2, C719.2, C720.2, C721.2, C723.2, C724.2, C725.2, C726.2, C727.2, C728.2, C729.2, C730.2, C731.2, C732.2, C733.2, C734.2, C735.2, C736.2, C737.2, C738.2, C739.2, C740.2, C741.2, C742.2, C743.2, R625.1, R627.2, R700.1, R701.1, U700.A9 (VSS), U700.B1 (VSSQ), U700.B3 (VSS), U700.B9 (VSSQ), U700.D1 (VSSQ), U700.D8 (VSSQ), U700.E1 (VSS), U700.E2 (VSSQ), U700.E8 (VSSQ), U700.F9 (VSSQ), U700.G1 (VSSQ), U700.G8 (VSS), U700.G9 (VSSQ), U700.J2 (VSS), U700.J8 (VSS), U700.M1 (VSS), U700.M9 (VSS), U700.P1 (VSS), U700.P9 (VSS), U700.T1 (VSS), U700.T9 (VSS), U701.A9 (VSS), U701.B1 (VSSQ), U701.B3 (VSS), U701.B9 (VSSQ), U701.D1 (VSSQ), U701.D8 (VSSQ), U701.E1 (VSS), U701.E2 (VSSQ), U701.E8 (VSSQ), U701.F9 (VSSQ), U701.G1 (VSSQ), U701.G8 (VSS), U701.G9 (VSSQ), U701.J2 (VSS), U701.J8 (VSS), U701.M1 (VSS), U701.M9 (VSS), U701.P1 (VSS), U701.P9 (VSS), U701.T1 (VSS), U701.T9 (VSS); also elsewhere on the board

Notes on the sheet:
ACC & DAT Connection
DDR_BL1
DDR_ACC
DDR_BL3
DDR_BL2
Diff Pair
DDR_BL0
Zynq DDR Interface
Power and Decoupling
