findasifrahman/zynq_soc_board_v1/zynq_soc_board_v1.kicad_pcb

## KiCad design zynq_soc_board_v1.kicad_pcb (continued)

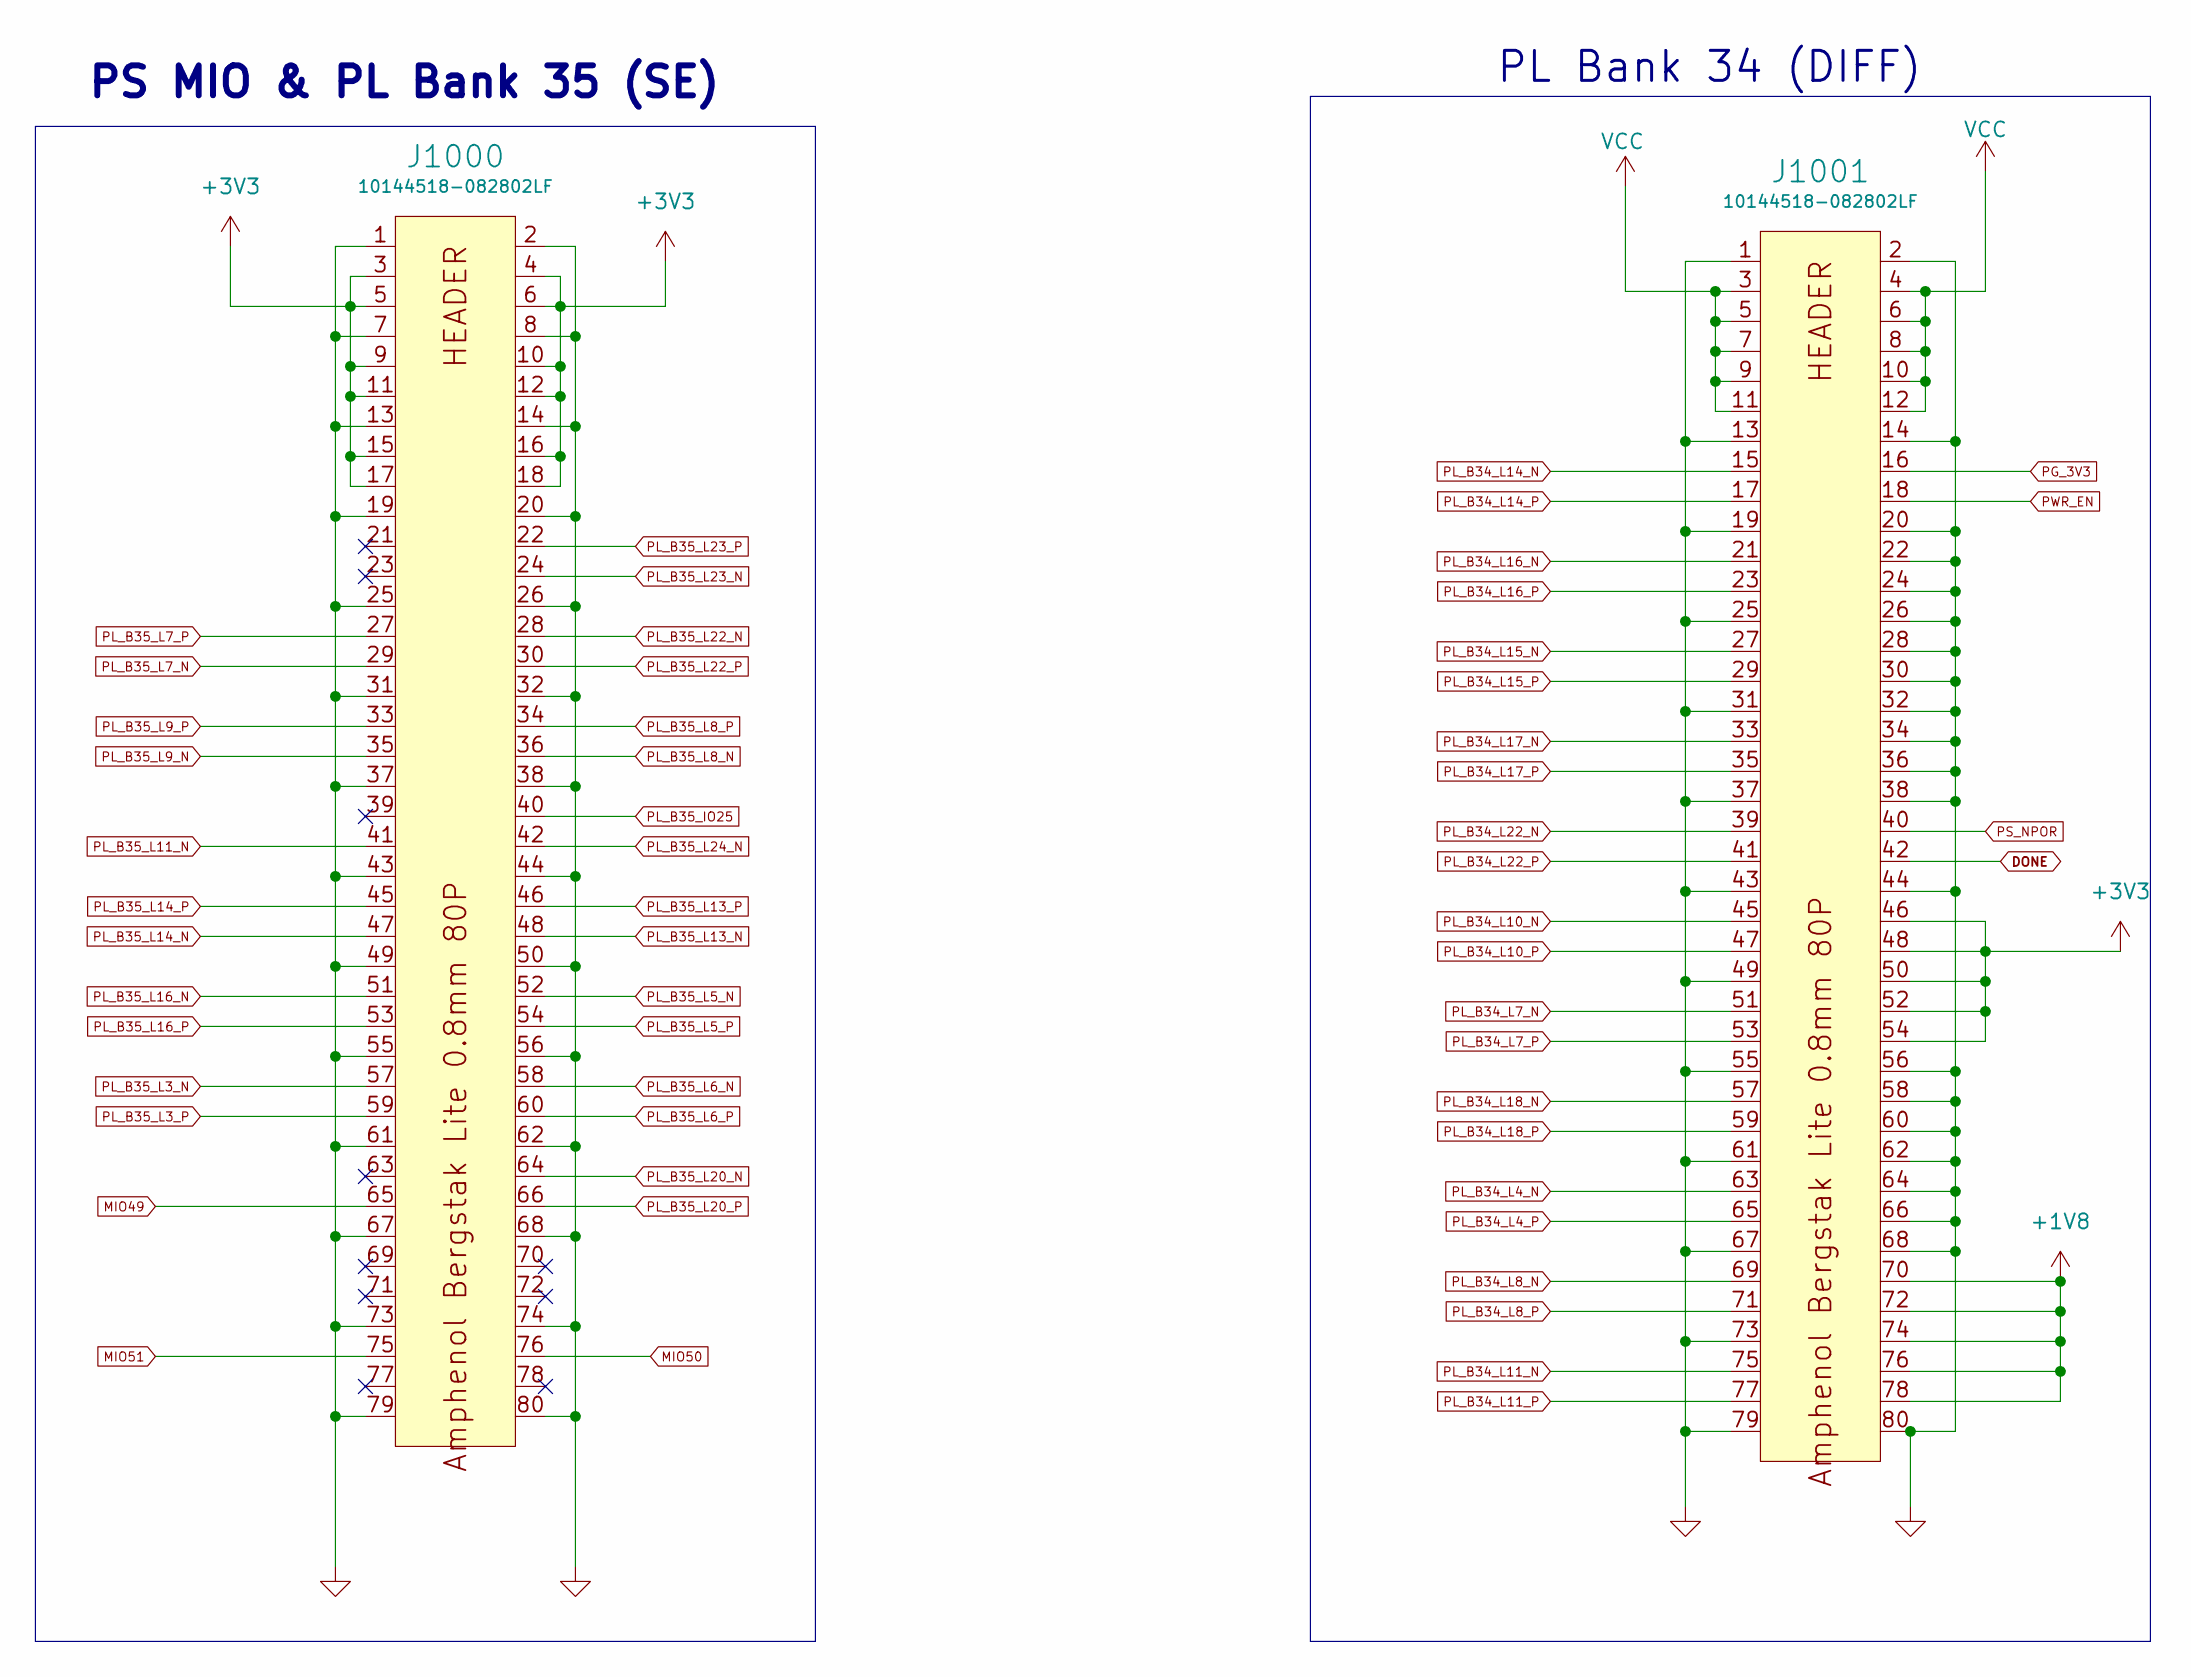
[picture p13: schematic Mezzanine Connectors.kicad_sch]

Parts:
J1000, J1001: 10144518-082802LF; Manufacturer Part Number 10144518-082802LF; LCSC C3653168

Connections:
+1V8: J1001.70, J1001.72, J1001.74, J1001.76, J1001.78; also elsewhere on the board
+3V3: J1000.3, J1000.4, J1000.5, J1000.6, J1000.9, J1000.10, J1000.11, J1000.12, J1000.15, J1000.16, J1000.17, J1000.18, J1001.46, J1001.48, J1001.50, J1001.52, J1001.54; also elsewhere on the board
DONE: J1001.42; also elsewhere on the board
GND: J1000.1, J1000.2, J1000.7, J1000.8, J1000.13, J1000.14, J1000.19, J1000.20, J1000.25, J1000.26, J1000.31, J1000.32, J1000.37, J1000.38, J1000.43, J1000.44, J1000.49, J1000.50, J1000.55, J1000.56, J1000.61, J1000.62, J1000.67, J1000.68, J1000.73, J1000.74, J1000.79, J1000.80, J1001.1, J1001.2, J1001.13, J1001.14, J1001.19, J1001.20, J1001.22, J1001.24, J1001.25, J1001.26, J1001.28, J1001.30, J1001.31, J1001.32, J1001.34, J1001.36, J1001.37, J1001.38, J1001.43, J1001.44, J1001.49, J1001.55, J1001.56, J1001.58, J1001.60, J1001.61, J1001.62, J1001.64, J1001.66, J1001.67, J1001.68, J1001.73, J1001.79, J1001.80; also elsewhere on the board
MIO49: J1000.65; also elsewhere on the board
MIO50: J1000.76; also elsewhere on the board
MIO51: J1000.75; also elsewhere on the board
PG_3V3: J1001.16; also elsewhere on the board
PL_B34_L4_N: J1001.63; also elsewhere on the board
PL_B34_L4_P: J1001.65; also elsewhere on the board
PL_B34_L7_N: J1001.51; also elsewhere on the board
PL_B34_L7_P: J1001.53; also elsewhere on the board
PL_B34_L8_N: J1001.69; also elsewhere on the board
PL_B34_L8_P: J1001.71; also elsewhere on the board
PL_B34_L10_N: J1001.45; also elsewhere on the board
PL_B34_L10_P: J1001.47; also elsewhere on the board
PL_B34_L11_N: J1001.75; also elsewhere on the board
PL_B34_L11_P: J1001.77; also elsewhere on the board
PL_B34_L14_N: J1001.15; also elsewhere on the board
PL_B34_L14_P: J1001.17; also elsewhere on the board
PL_B34_L15_N: J1001.27; also elsewhere on the board
PL_B34_L15_P: J1001.29; also elsewhere on the board
PL_B34_L16_N: J1001.21; also elsewhere on the board
PL_B34_L16_P: J1001.23; also elsewhere on the board
PL_B34_L17_N: J1001.33; also elsewhere on the board
PL_B34_L17_P: J1001.35; also elsewhere on the board
PL_B34_L18_N: J1001.57; also elsewhere on the board
PL_B34_L18_P: J1001.59; also elsewhere on the board
PL_B34_L22_N: J1001.39; also elsewhere on the board
PL_B34_L22_P: J1001.41; also elsewhere on the board
PL_B35_IO25: J1000.40; also elsewhere on the board
PL_B35_L3_N: J1000.57; also elsewhere on the board
PL_B35_L3_P: J1000.59; also elsewhere on the board
PL_B35_L5_N: J1000.52; also elsewhere on the board
PL_B35_L5_P: J1000.54; also elsewhere on the board
PL_B35_L6_N: J1000.58; also elsewhere on the board
PL_B35_L6_P: J1000.60; also elsewhere on the board
PL_B35_L7_N: J1000.29; also elsewhere on the board
PL_B35_L7_P: J1000.27; also elsewhere on the board
PL_B35_L8_N: J1000.36; also elsewhere on the board
PL_B35_L8_P: J1000.34; also elsewhere on the board
PL_B35_L9_N: J1000.35; also elsewhere on the board
PL_B35_L9_P: J1000.33; also elsewhere on the board
PL_B35_L11_N: J1000.41; also elsewhere on the board
PL_B35_L13_N: J1000.48; also elsewhere on the board
PL_B35_L13_P: J1000.46; also elsewhere on the board
PL_B35_L14_N: J1000.47; also elsewhere on the board
PL_B35_L14_P: J1000.45; also elsewhere on the board
PL_B35_L16_N: J1000.51; also elsewhere on the board
PL_B35_L16_P: J1000.53; also elsewhere on the board
PL_B35_L20_N: J1000.64; also elsewhere on the board
PL_B35_L20_P: J1000.66; also elsewhere on the board
PL_B35_L22_N: J1000.28; also elsewhere on the board
PL_B35_L22_P: J1000.30; also elsewhere on the board
PL_B35_L23_N: J1000.24; also elsewhere on the board
PL_B35_L23_P: J1000.22; also elsewhere on the board
PL_B35_L24_N: J1000.42; also elsewhere on the board
PS_NPOR: J1001.40; also elsewhere on the board
PWR_EN: J1001.18; also elsewhere on the board
VCC: J1001.3, J1001.4, J1001.5, J1001.6, J1001.7, J1001.8, J1001.9, J1001.10, J1001.11, J1001.12; also elsewhere on the board

Notes on the sheet:
PS MIO & PL Bank 35 (SE)
PL Bank 34 (DIFF)

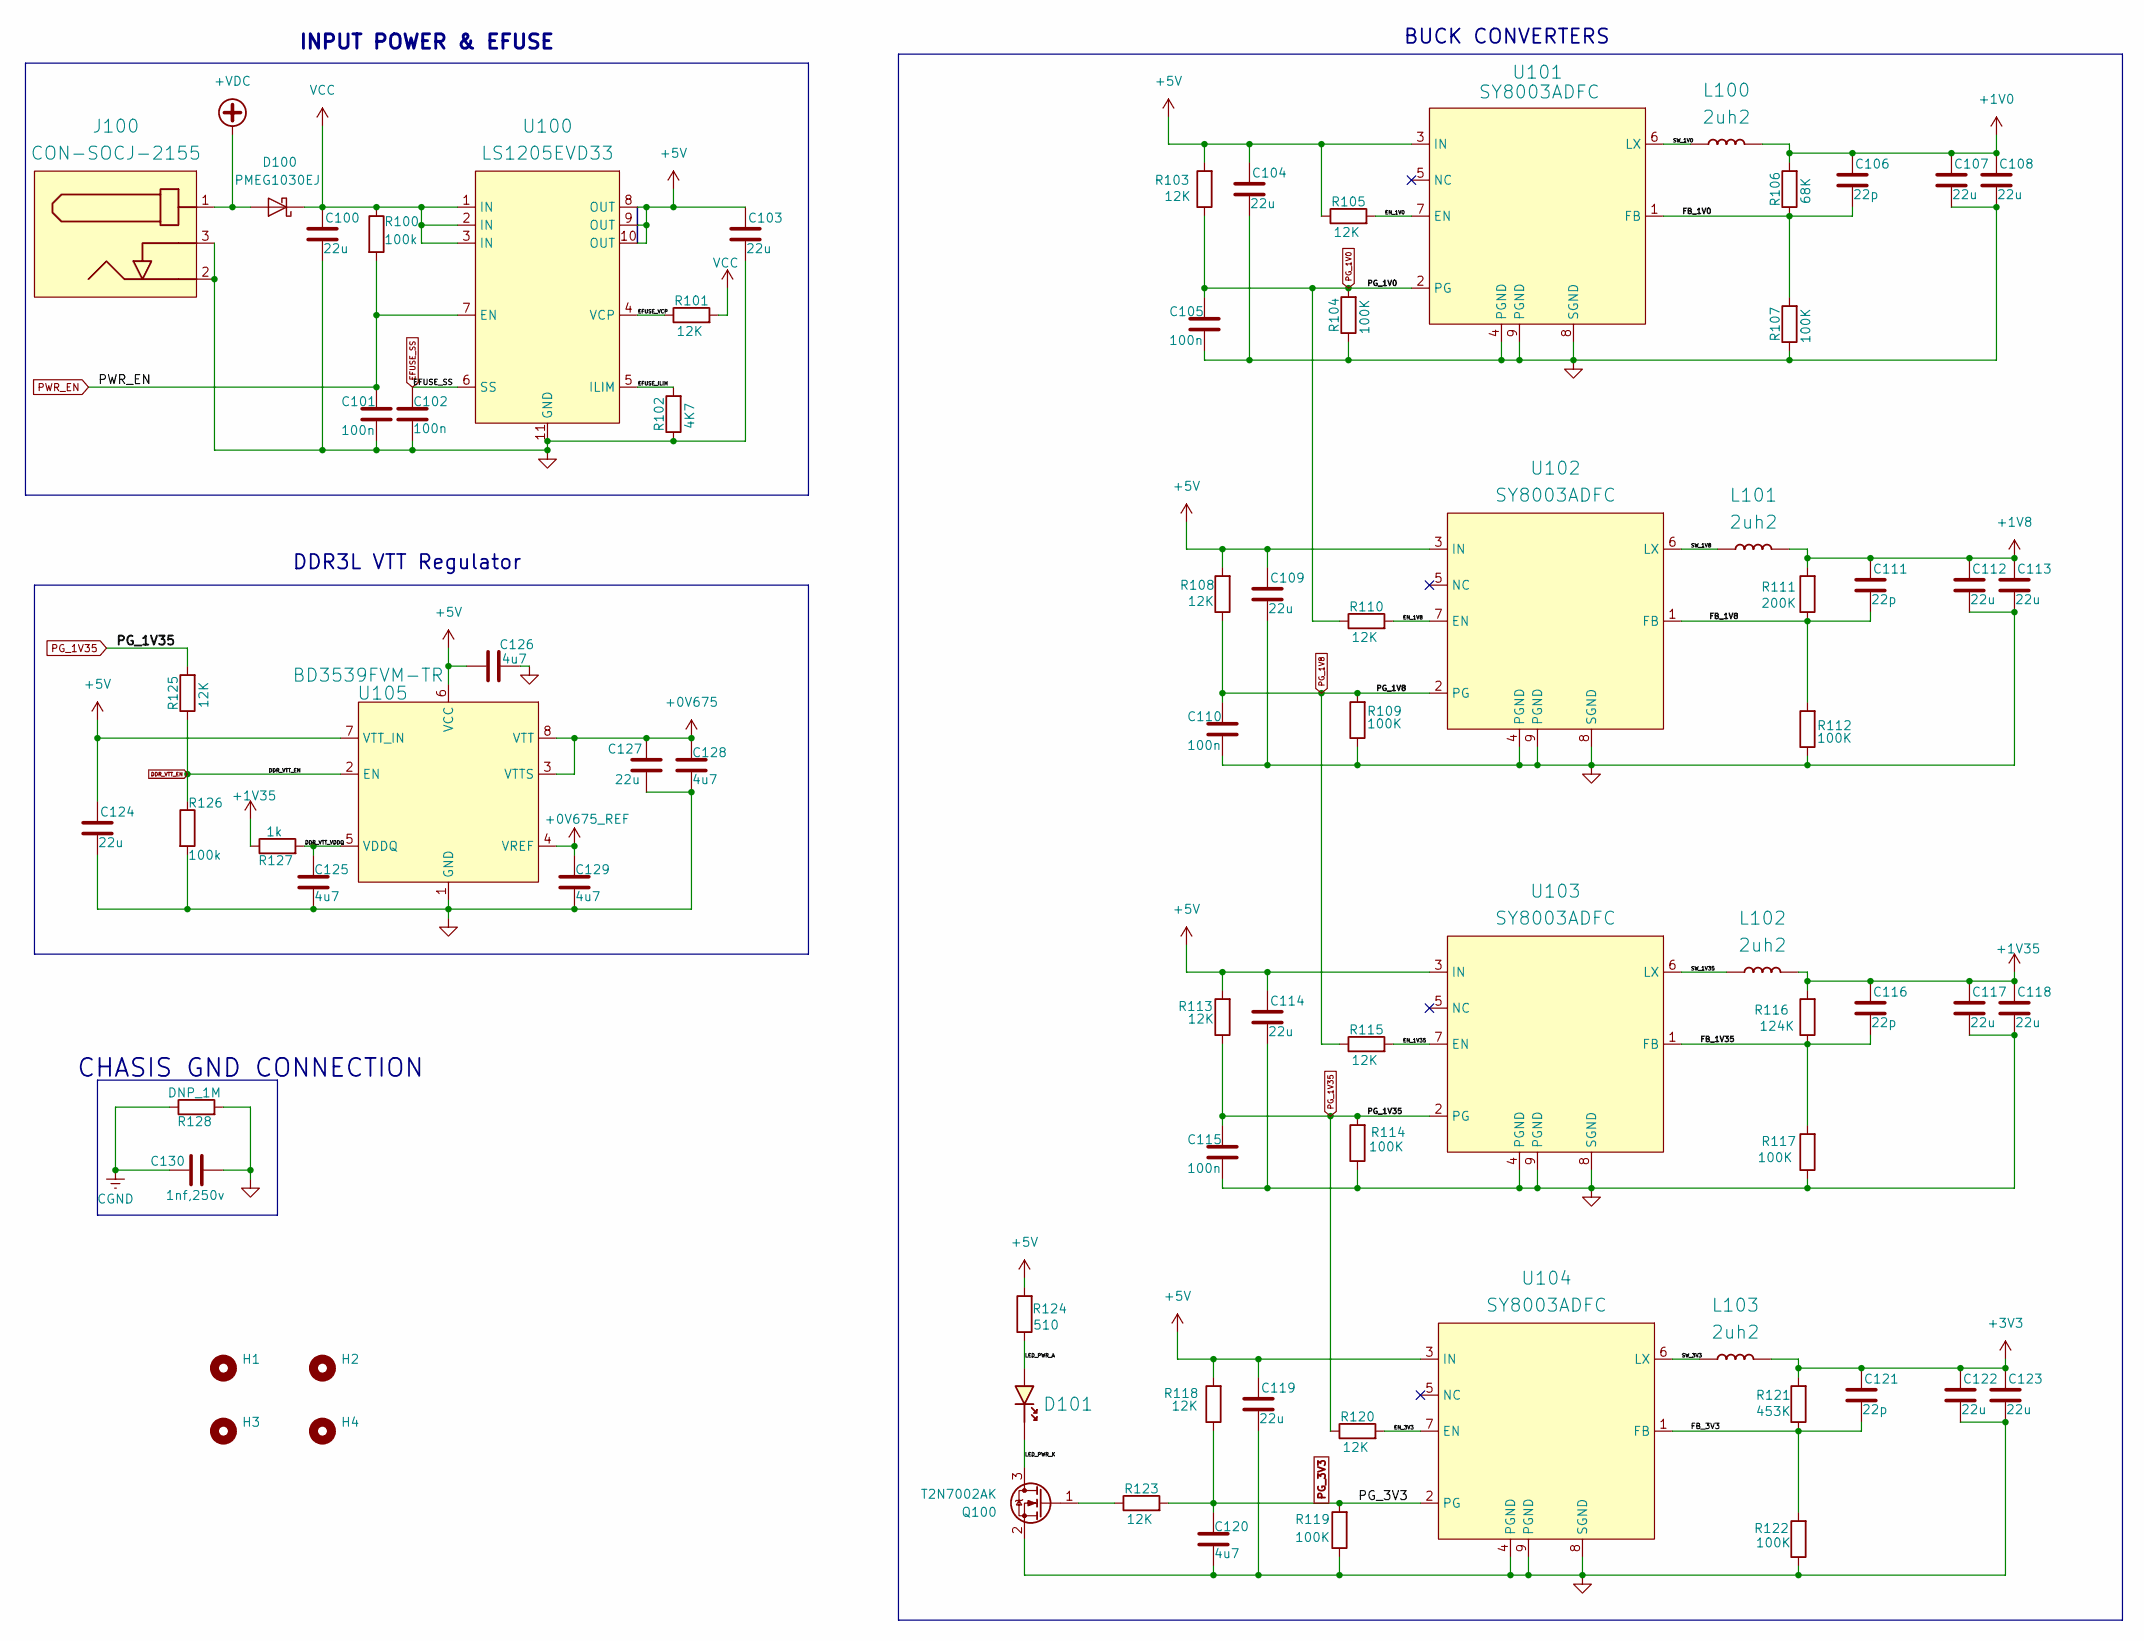
[picture p14: schematic power.kicad_sch]

Parts:
C100, C103, C104, C107, C108, C109, C112, C113, C114, C117, C118, C119, C122, C123, C124, C127: 22u; C0805; Manufacturer Part Number CL21A226MAQNNNE; LCSC C45783
C101, C102, C105, C110, C115: 100n; C_0402_1005Metric; Manufacturer Part Number CL05B104KO5NNNC; LCSC C1525
C106, C111, C116, C121: 22p; C_0402_1005Metric; Manufacturer Part Number 0402CG220J500NT; LCSC C1555
C120, C125, C126, C128, C129: 4u7; C_0402_1005Metric; Manufacturer Part Number CL05A475MP5NRNC; LCSC C23733
C130: 1nf,250v; C2211; Manufacturer Part Number GA352QR7GF102KW01L; LCSC C91599
D100: PMEG1030EJ; D_SOD-323F; LCSC C133633
D101: RED; LED_0402_RED; Manufacturer Part Number NCD0402R1; LCSC C130719
H1, H2, H3, H4: MountingHole; MountingHole_3.2mm_M3
J100: CON-SOCJ-2155; DC-IN-TH_DC005-T20; Manufacturer Part Number CON-SOCJ-2155; LCSC C111567
L100, L101, L102, L103: 2uh2; IND-SMD_L4.4-W4.1; Manufacturer Part Number SRP0415-2R2K; LCSC C1858073
Q100: T2N7002AK; SOT-23; Manufacturer Part Number T2N7002AK,LM; LCSC C516175
R100, R126: 100k; R_0402_1005Metric; Manufacturer Part Number 0402WGF1003TCE; LCSC C25741
R101, R103, R105, R108, R110, R113, R115, R118, R120, R123, R125: 12K; R_0402_1005Metric; Manufacturer Part Number 0402WGF1202TCE; LCSC C25752
R102: 4K7; R_0402_1005Metric; Manufacturer Part Number 0402WGF4701TCE; LCSC C25900
R104, R107, R109, R112, R114, R117, R119, R122: 100K; R_0402_1005Metric; Manufacturer Part Number 0402WGF1003TCE; LCSC C25741
R106: 68K; R_0402_1005Metric; Manufacturer Part Number 0603WAF6802T5E; LCSC C23231
R111: 200K; R_0402_1005Metric; Manufacturer Part Number 0402WGF2003TCE; LCSC C25764
R116: 124K; R_0402_1005Metric; Manufacturer Part Number 0402WGF1243TCE; LCSC C36777
R121: 453K; R_0402_1005Metric; Manufacturer Part Number 0402WGF4533TCE; LCSC C27009
R124: 510; R_0402_1005Metric; Manufacturer Part Number RC-02W511JT; LCSC C1119
R127: 1k; R_0402_1005Metric; Manufacturer Part Number 0402WGF1001TCE; LCSC C11702
R128: DNP_1M; R_0402_1005Metric
U100: LS1205EVD33; DFN3x3_10L; Manufacturer Part Number LS1205EVD33; LCSC C6653278
U101, U102, U103, U104: SY8003ADFC; DFN-8_L2.0-W2.0-P0.50-LS2.0-BL-EP; Manufacturer Part Number High Efficiency 5.5V, 3A continuous, 1M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; LCSC C178236
U105: BD3539FVM-TR; MSOP8; Manufacturer Part Number BD3539FVM-TR; LCSC C213437

Connections:
+0V675: C127.1, C128.1, U105.3 (VTTS), U105.8 (VTT); also elsewhere on the board
+0V675_REF: C129.1, U105.4 (VREF); also elsewhere on the board
+1V0: C106.1, C107.1, C108.1, L100.2, R106.2; also elsewhere on the board
+1V8: C111.1, C112.1, C113.1, L101.2, R111.2; also elsewhere on the board
+1V35: C116.1, C117.1, C118.1, L102.2, R116.2, R127.1; also elsewhere on the board
+3V3: C121.1, C122.1, C123.1, L103.2, R121.2; also elsewhere on the board
+5V: C103.1, C104.1, C109.1, C114.1, C119.1, C124.1, C126.1, R103.2, R105.1, R108.2, R113.2, R118.2, R124.2, U100.8 (OUT), U100.9 (OUT), U100.10 (OUT), U101.3 (IN), U102.3 (IN), U103.3 (IN), U104.3 (IN), U105.6 (VCC), U105.7 (VTT_IN)
+VDC: D100.2 (A), J100.1
/power/DDR_VTT_VDDQ: C125.1, R127.2, U105.5 (VDDQ)
/power/EFUSE_ILIM: R102.2, U100.5 (ILIM)
/power/EFUSE_VCP: R101.1, U100.4 (VCP)
/power/EN_1V0: R105.2, U101.7 (EN)
/power/EN_1V8: R110.2, U102.7 (EN)
/power/EN_1V35: R115.2, U103.7 (EN)
/power/EN_3V3: R120.2, U104.7 (EN)
/power/FB_1V0: C106.2, R106.1, R107.2, U101.1 (FB)
/power/FB_1V8: C111.2, R111.1, R112.2, U102.1 (FB)
/power/FB_1V35: C116.2, R116.1, R117.2, U103.1 (FB)
/power/FB_3V3: C121.2, R121.1, R122.2, U104.1 (FB)
/power/LED_PWR_A: D101.A, R124.1
/power/LED_PWR_K: D101.K, Q100.3 (D)
/power/SW_1V0: L100.1, U101.6 (LX)
/power/SW_1V8: L101.1, U102.6 (LX)
/power/SW_1V35: L102.1, U103.6 (LX)
/power/SW_3V3: L103.1, U104.6 (LX)
CGND: C130.1, R128.1; also elsewhere on the board
DDR_VTT_EN: R125.1, R126.1, U105.2 (EN)
EFUSE_SS: C102.1, U100.6 (SS)
GND: C100.2, C101.2, C102.2, C103.2, C104.2, C105.2, C107.2, C108.2, C109.2, C110.2, C112.2, C113.2, C114.2, C115.2, C117.2, C118.2, C119.2, C120.2, C122.2, C123.2, C124.2, C125.2, C126.2, C127.2, C128.2, C129.2, C130.2, J100.2, J100.3, Q100.2 (S), R102.1, R104.1, R107.1, R109.1, R112.1, R114.1, R117.1, R119.1, R122.1, R126.2, R128.2, U100.11 (GND), U101.4 (PGND), U101.8 (SGND), U101.9 (PGND), U102.4 (PGND), U102.8 (SGND), U102.9 (PGND), U103.4 (PGND), U103.8 (SGND), U103.9 (PGND), U104.4 (PGND), U104.8 (SGND), U104.9 (PGND), U105.1 (GND); also elsewhere on the board
unnamed: Q100.1 (G), R123.1
PG_1V0: C105.1, R103.1, R104.2, R110.1, U101.2 (PG)
PG_1V8: C110.1, R108.1, R109.2, R115.1, U102.2 (PG)
PG_1V35: C115.1, R113.1, R114.2, R120.1, R125.2, U103.2 (PG)
PG_3V3: C120.1, R118.1, R119.2, R123.2, U104.2 (PG); also elsewhere on the board
PWR_EN: C101.1, R100.2, U100.7 (EN); also elsewhere on the board
VCC: C100.1, D100.1 (K), R100.1, R101.2, U100.1 (IN), U100.2 (IN), U100.3 (IN); also elsewhere on the board

Notes on the sheet:
INPUT POWER & EFUSE
DDR3L VTT Regulator
BUCK CONVERTERS
CHASIS GND CONNECTION

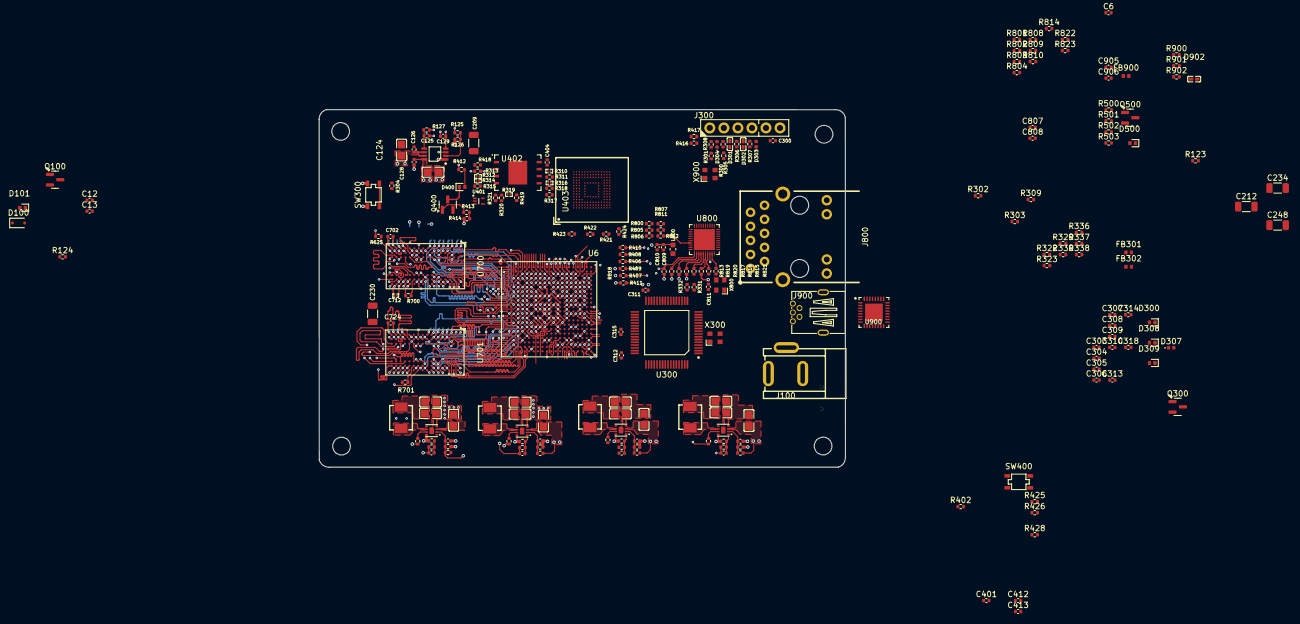
[picture p15: board zynq_soc_board_v1.kicad_pcb from above]

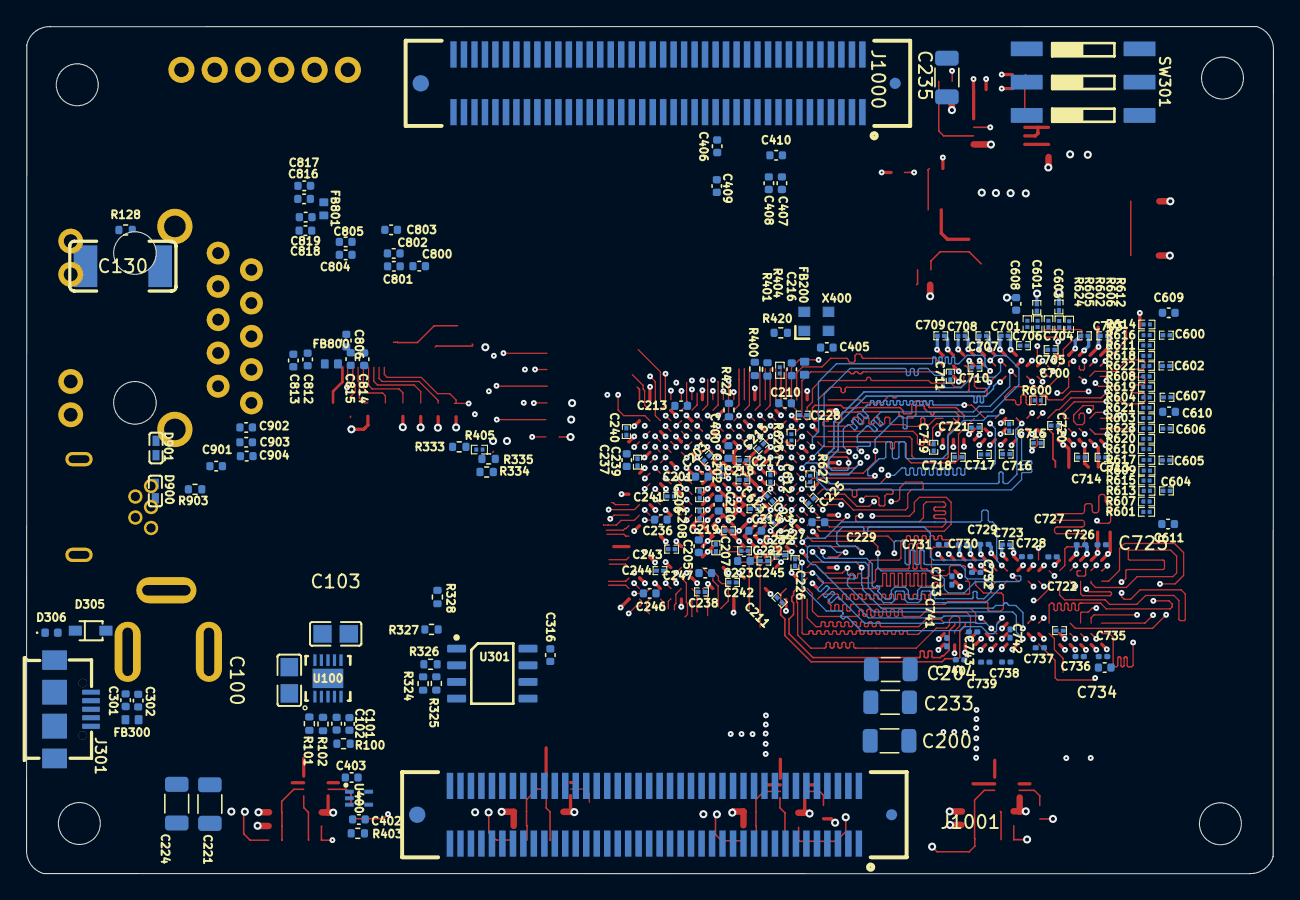
[picture p16: board zynq_soc_board_v1.kicad_pcb from below]

Board: 10 copper layers, 95.1 x 64.6 mm, 424 parts (198 on the bottom side), 316 nets.

Other parts of the board:
C12, C13: 47n; C_0402_1005Metric

Their connections:
+0V675_REF: C12.2, C13.1; also elsewhere on the board
+1V35: C12.1; also elsewhere on the board
GND: C13.2; also elsewhere on the board
