findasifrahman/zynq_soc_board_v1/(commit log)

2024-11-30 PDF ADDED
    [power.kicad_sch, zynq_ddr.kicad_sch, zynq_jtag.kicad_sch, zynq_power.kicad_sch, zynq_processing_system_ps.kicad_sch, zynq_programmable_logic.kicad_sch]
2024-12-03 sch updated zynq ddr
    [ethernet.kicad_sch, zynq_ddr.kicad_sch, zynq_jtag.kicad_sch, zynq_power.kicad_sch, zynq_processing_system_ps.kicad_sch, zynq_programmable_logic.kicad_sch, zynq_soc_board_v1.kicad_sch]
2024-12-05 all page
    [Mezzanine Connectors.kicad_sch, USB-2-HS.kicad_sch, ethernet.kicad_sch, power.kicad_sch, zynq_ddr.kicad_sch, zynq_jtag.kicad_sch, zynq_power.kicad_sch, zynq_processing_system_ps.kicad_sch]
2025-01-03 usb hs update
    [USB-2-HS.kicad_sch, ethernet.kicad_sch, power.kicad_sch, zynq_jtag.kicad_sch]
2025-01-08 pcb layers
    [Mezzanine Connectors.kicad_sch, USB-2-HS.kicad_sch, power.kicad_sch, zynq_jtag.kicad_sch, zynq_processing_system_ps.kicad_sch]
2025-01-13 rev a done
    [BOM-zynq_soc_board_v1.csv, USB-2-HS.kicad_sch, ethernet.kicad_sch, power.kicad_sch, zynq_processing_system_ps.kicad_sch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]
